electronobserver/smartnixie/README.md

<div align="center">

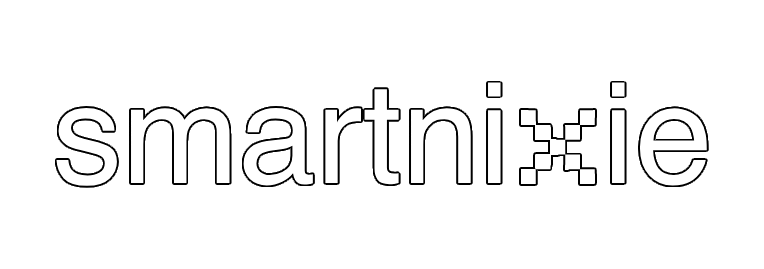
[picture p1: img/smartnixie.png]
Smart Nixie Smartnixie: An ESP32 powered smart home nixie clock


<span>━━━━━━ ⬢ ━━━━━━</span>

An ESP32-powered smart home Nixie Clock with customizable RGB backlighting, Wi-Fi connectivity, and a companion control app.

[About](#about) | [Guide](/) | [Credits](/)

---
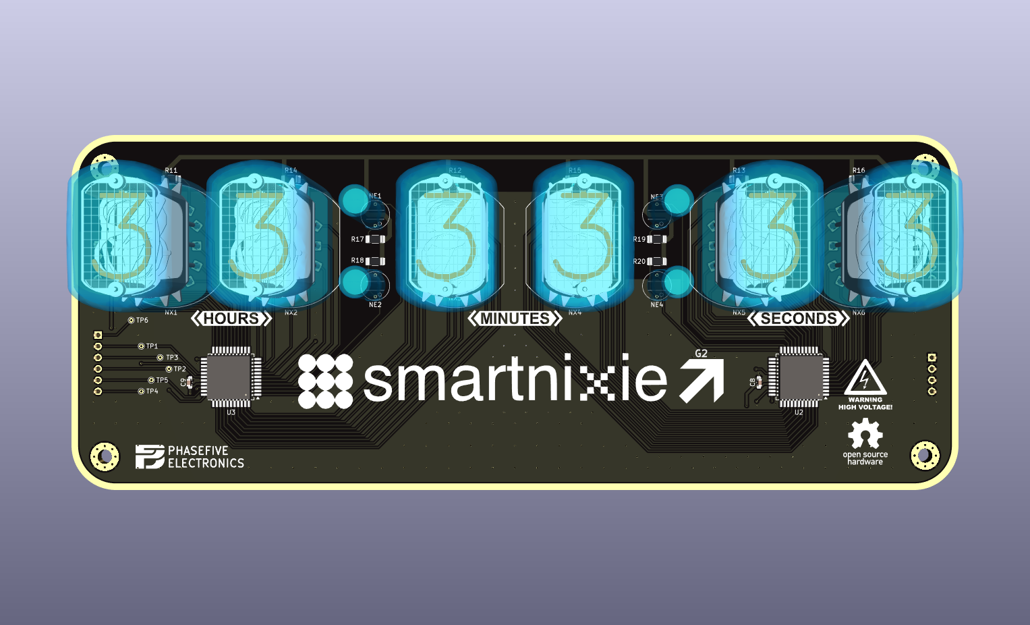
[picture p2: img/clock_face.png]
Front Clock Face PCB

(Display Board PCB)

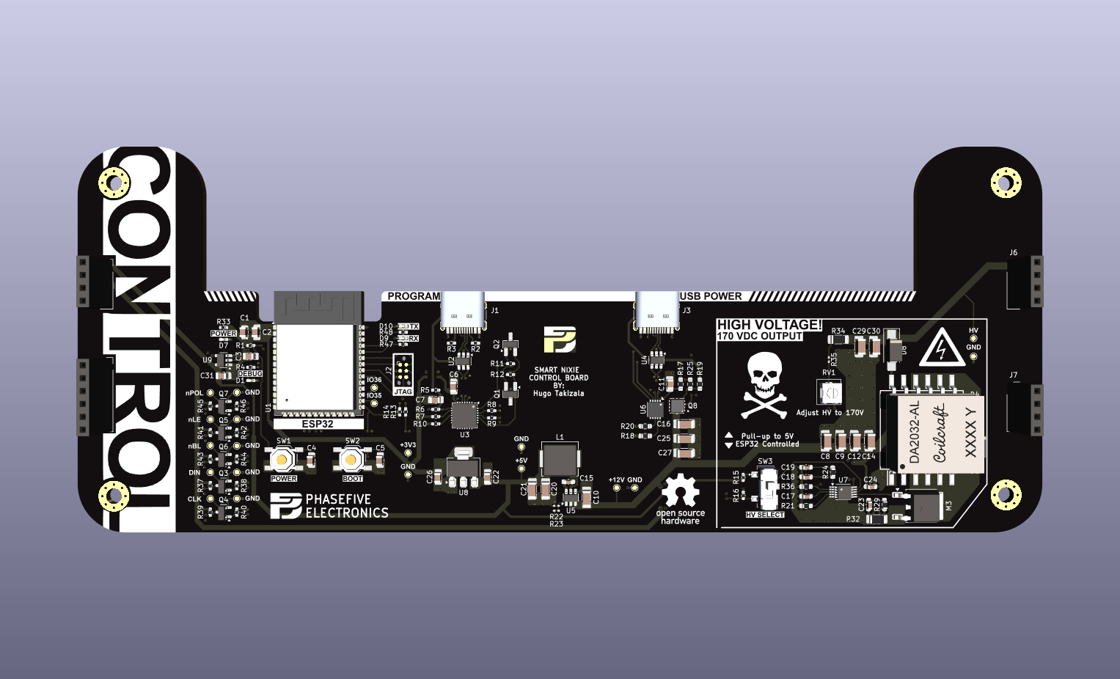
[picture p3: img/control_board.png]
Front Control Board PCB

(Control Board PCB)
</div>

# About

> [!WARNING]
> This project is currently a work in progress and as of now, no hardware has been tested. Take everything on this repository with a grain of salt. You can read up on this project's development process [here](https://electron.observer/posts/smartnixie).
>
# Credits
- **Symbols and Footprints:** [Nixies US](https://github.com/judge2005/Eagle-and-KiCAD-Nixie-Libs)
- **HV Power Supply:** [Tony Pottier (tonyp7)](https://github.com/tonyp7/170v-nixie-power-supply)
