electronobserver/smartnixie/hardware/img/clock_face_3D.png

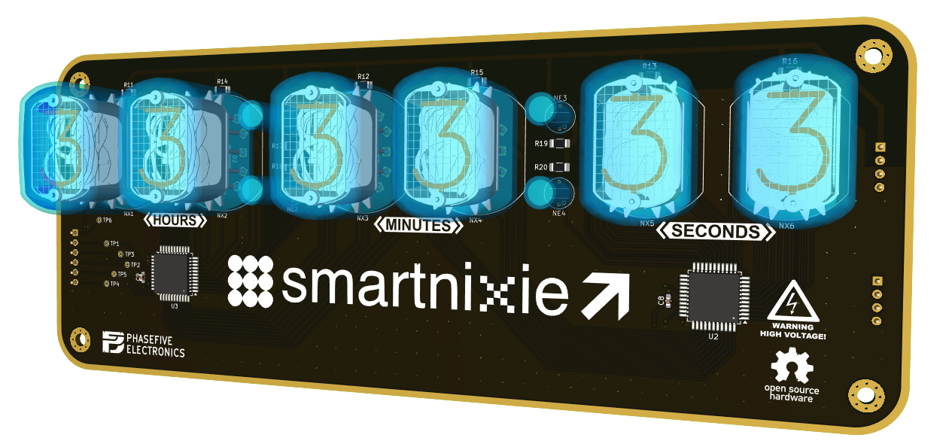
hardware/img/clock_face_3D.png
