electronobserver/smartnixie/hardware/img/control_board_3D_back.png

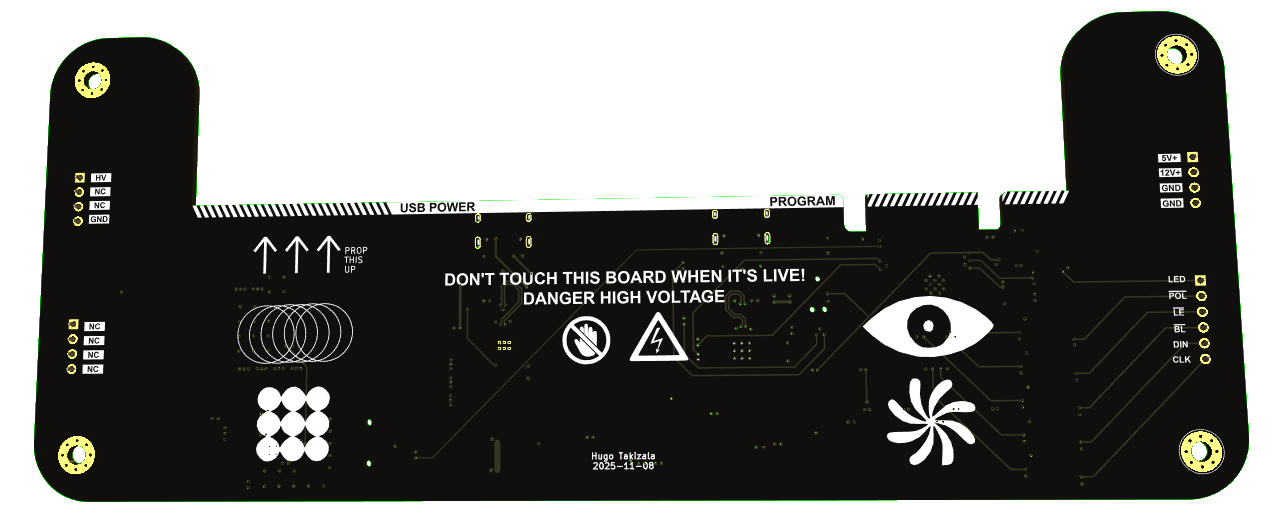
hardware/img/control_board_3D_back.png
