electronobserver/smartnixie/hardware/img/control_board_3D_front.png

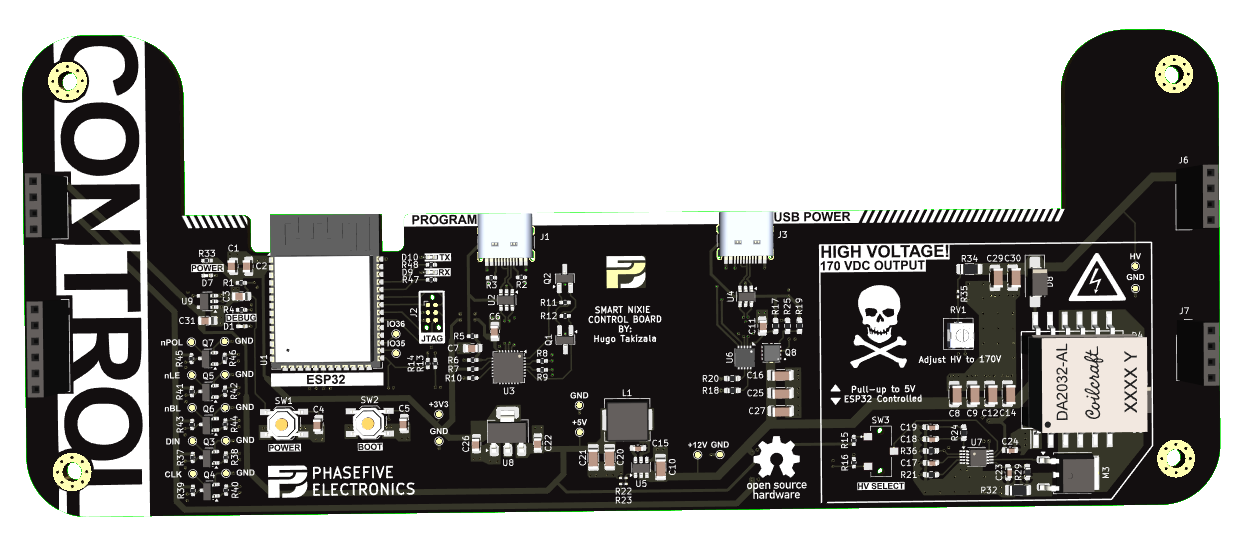
hardware/img/control_board_3D_front.png
