electronobserver/smartnixie/hardware/img/USB-C.jpeg

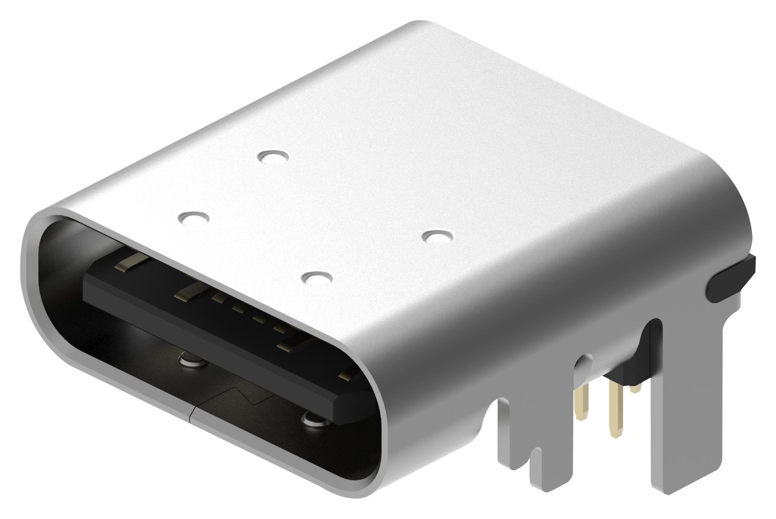
hardware/img/USB-C.jpeg
