electronobserver/smartnixie/hardware/models/3314J-1-100E.STEP

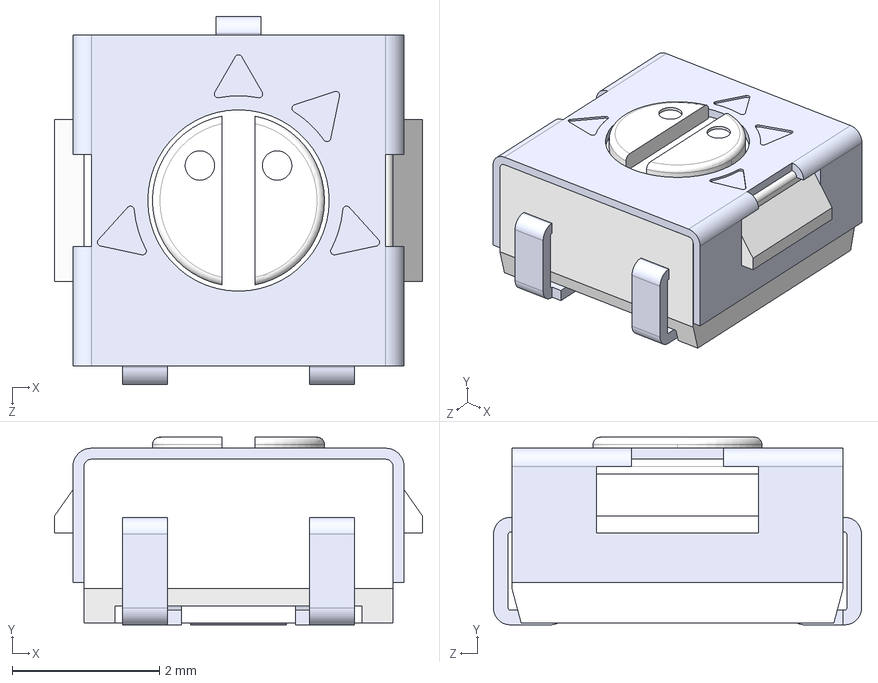
[picture p8: CAD file, 2025-09-29]
hardware/models/3314J-1-100E.STEP
5.00 x 2.55 x 5.00 mm
