electronobserver/smartnixie/hardware/models/CL-SB-12B-01T.step

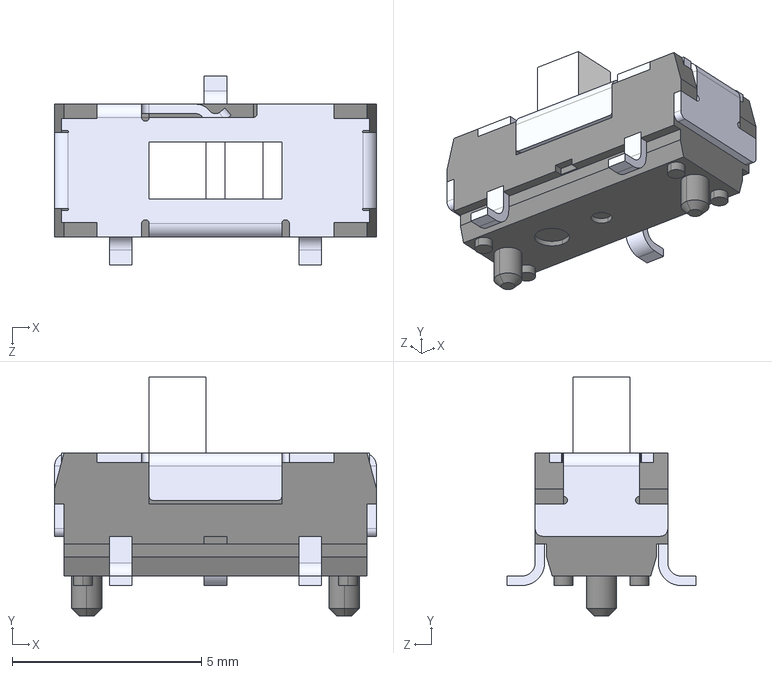
[picture p9: CAD file, 2025-09-29]
hardware/models/CL-SB-12B-01T.step
8.50 x 6.30 x 5.00 mm
