electronobserver/smartnixie/hardware/models/WS2812B.step

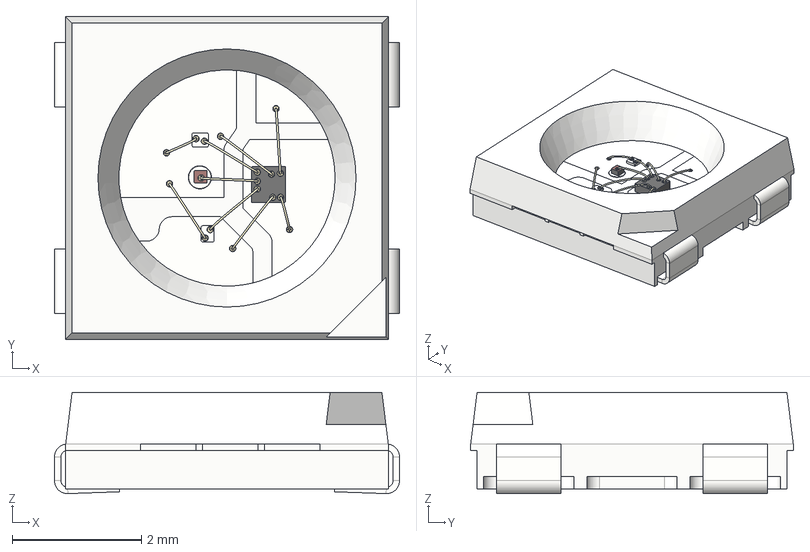
[picture p10: CAD file, 2025-09-29]
hardware/models/WS2812B.step
5.35 x 5.00 x 1.57 mm
