electronobserver/smartnixie/hardware/models/IN-12A.STEP

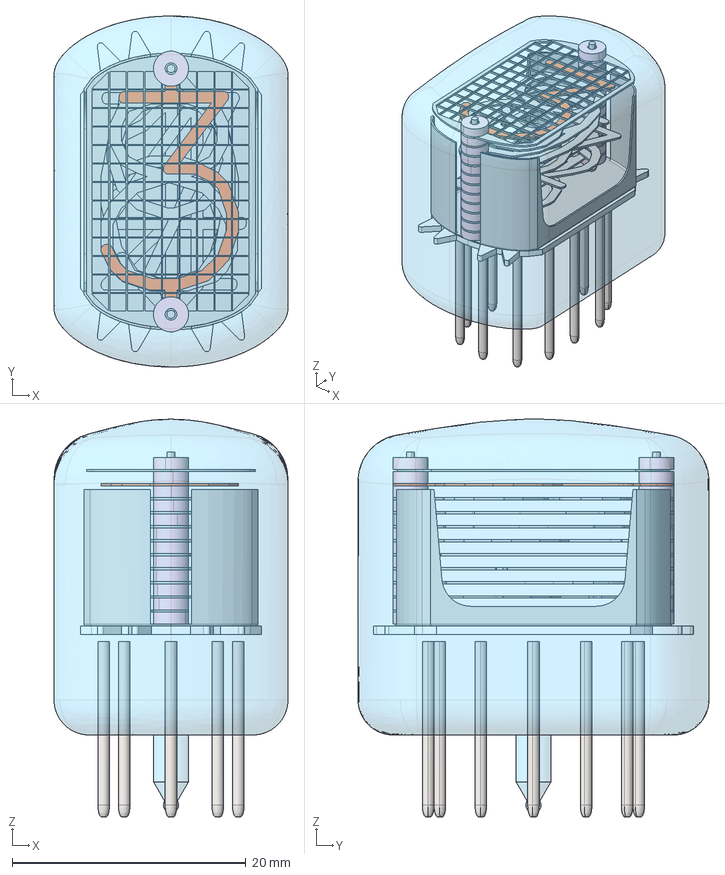
[picture p11: CAD file, 2025-09-29]
hardware/models/IN-12A.STEP
20.0 x 30.0 x 34.0 mm
IN-12 nixie tube glass body
IN-12 nixie tube pin x 12
IN-12 nixie tube anode grid
IN-12 nixie tube 0 digit
IN-12 nixie tube 1 digit
IN-12 nixie tube 2 digit
IN-12 nixie tube 3 digit
IN-12 nixie tube 4 digit
IN-12 nixie tube 5 digit
IN-12 nixie tube 6 digit
IN-12 nixie tube 7 digit
IN-12 nixie tube 8 digit
IN-12 nixie tube 9 digit
IN-12 nixie tube spacer x 24
IN-12 nixie tube rod x 2
IN-12 nixie tube back plate 1
IN-12 nixie tube back plate 2
