electronobserver/smartnixie/hardware/models/USB Type C Port (SMD Type).STEP

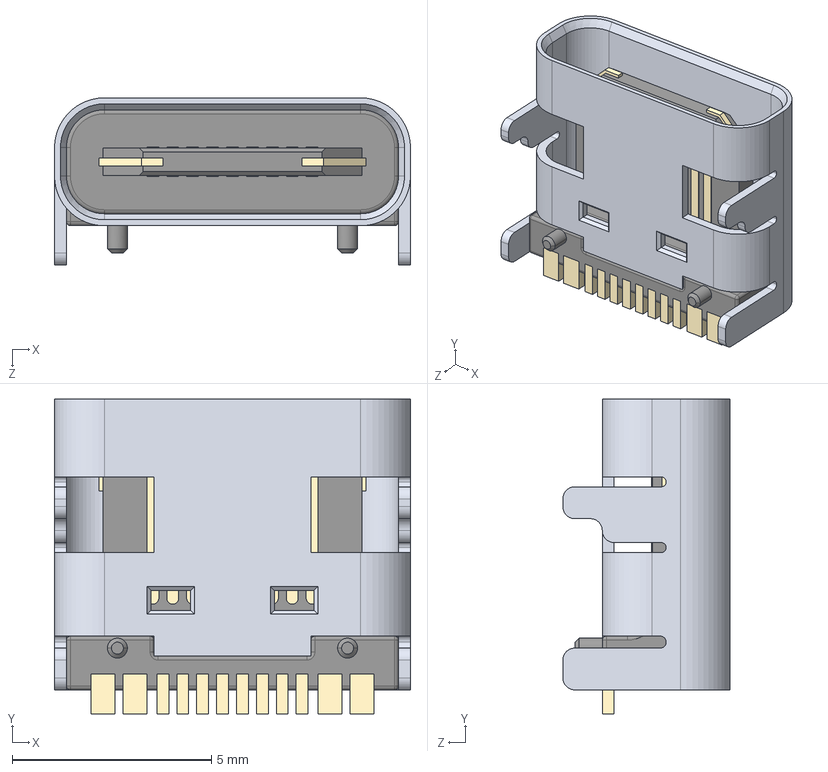
[picture p12: CAD file, 2025-09-29]
hardware/models/USB Type C Port (SMD Type).STEP
8.94 x 7.90 x 4.20 mm
