electronobserver/smartnixie/hardware/models/AONR21307.step

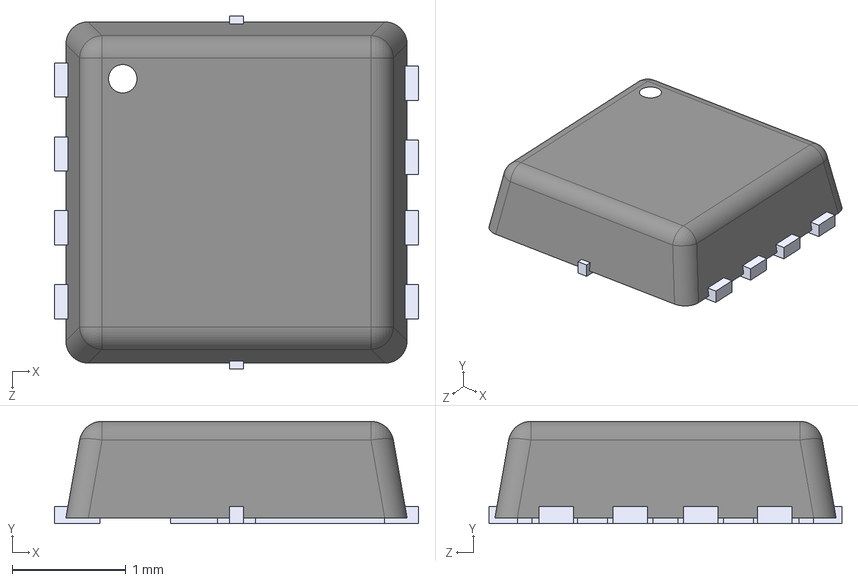
[picture p13: CAD file, 2025-09-29]
hardware/models/AONR21307.step
3.20 x 0.9 x 3.10 mm
