electronobserver/smartnixie/hardware/models/Coilcraft-DA2032-AL.STEP

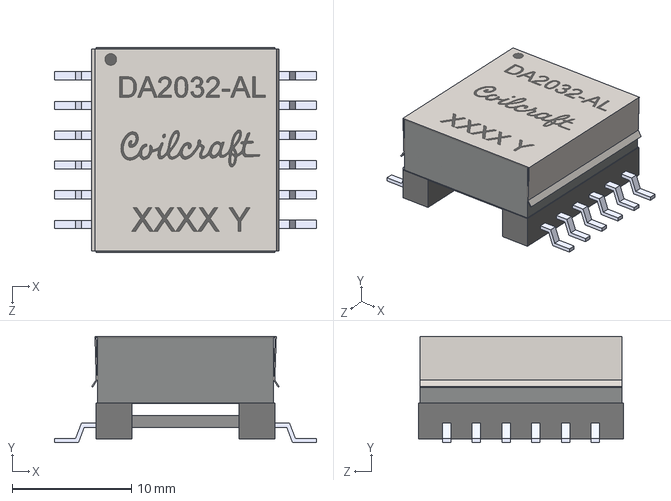
[picture p14: CAD file, 2025-09-29]
hardware/models/Coilcraft-DA2032-AL.STEP
22.0 x 8.94 x 17.2 mm
