electronobserver/smartnixie/hardware/models/INS1.STEP

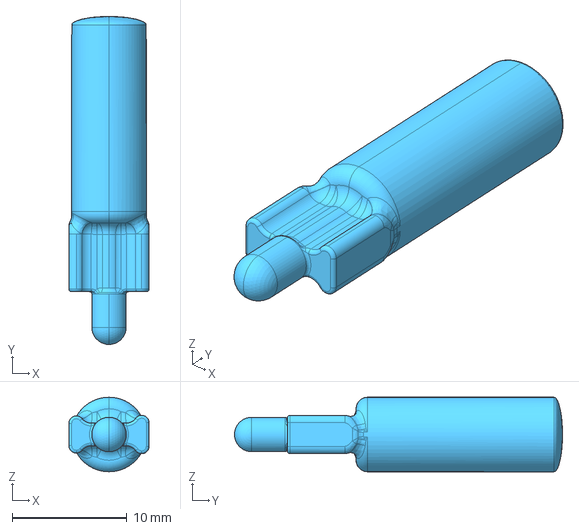
[picture p15: CAD file, 2025-09-29]
hardware/models/INS1.STEP
7.00 x 28.6 x 6.50 mm
