electronobserver/smartnixie/hardware/models/User Library-My-DFN-10-3x3-0_5.STEP

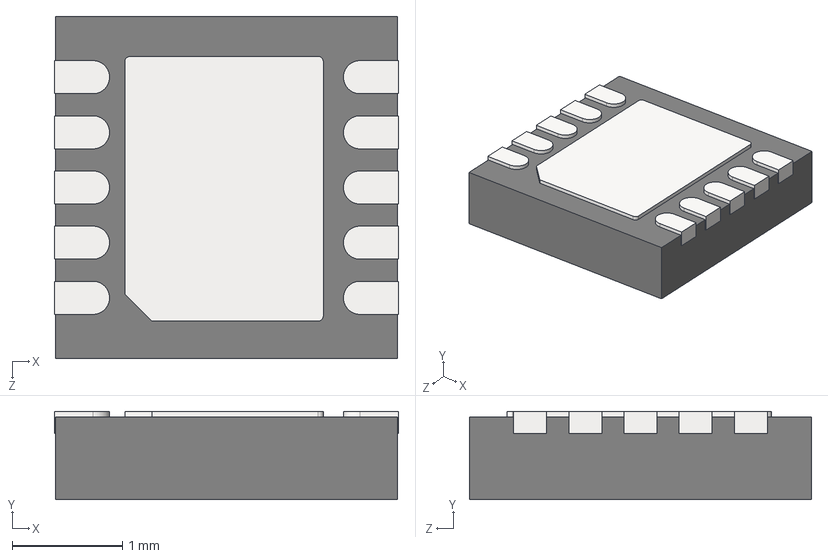
[picture p16: CAD file, 2025-09-29]
hardware/models/User Library-My-DFN-10-3x3-0_5.STEP
3.12 x 0.8 x 3.10 mm
TP
