electronobserver/smartnixie/hardware/models/TPS61088RHLR.step

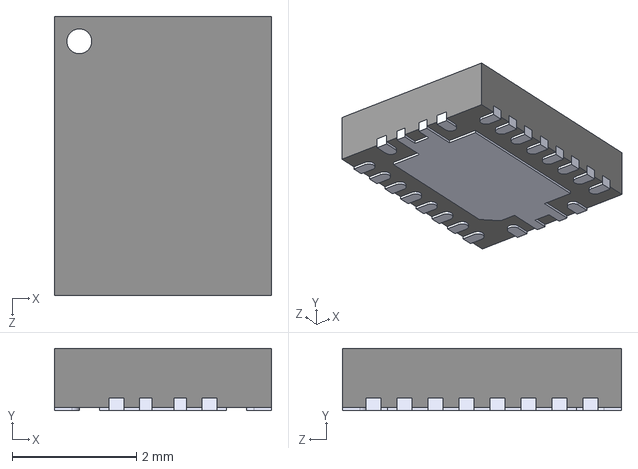
[picture p17: CAD file, 2025-09-29]
hardware/models/TPS61088RHLR.step
3.50 x 1.00 x 4.50 mm
