electronobserver/smartnixie/hardware/clock_face/clock_face.kicad_pcb

## KiCad design hardware/clock_face/clock_face.kicad_pcb (2025-11-08)

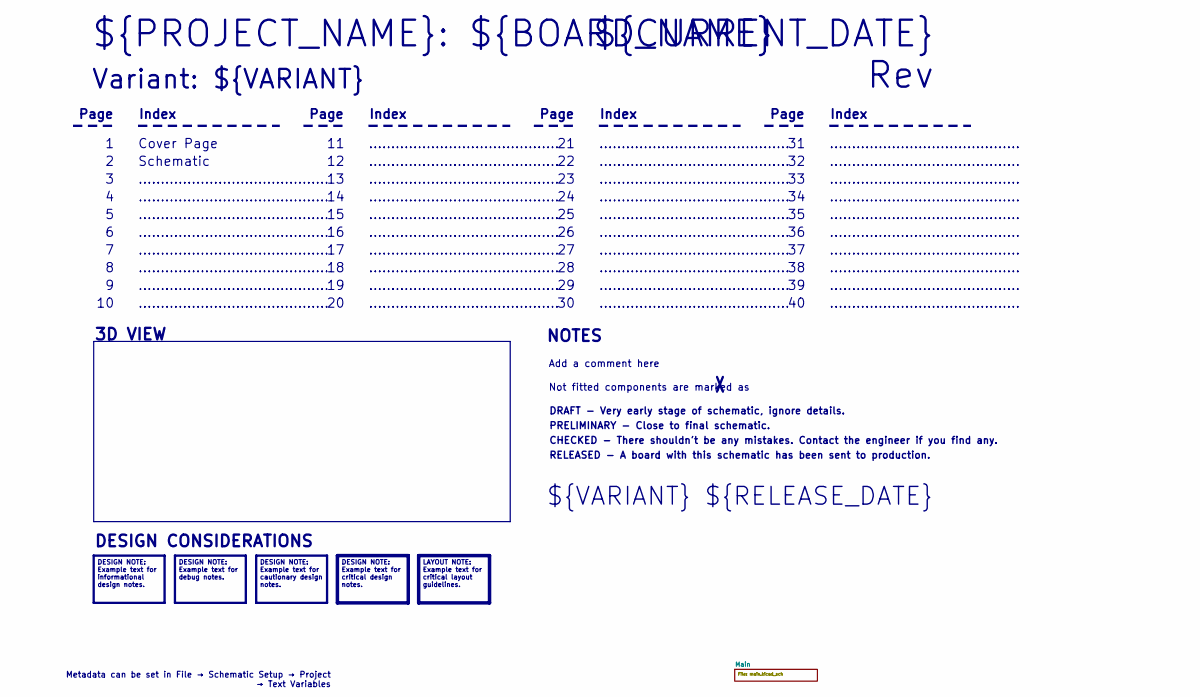
[picture p18: schematic clock_face.kicad_sch]

Notes on the sheet:
Metadata can be set in File → Schematic Setup → Project → Text Variables
DESIGN NOTE: Example text for informational design notes.
LAYOUT NOTE: Example text for critical layout guidelines.
DESIGN NOTE: Example text for cautionary design notes.
DESIGN NOTE: Example text for debug notes.
DESIGN NOTE: Example text for critical design notes.
...........................................
RELEASED - A board with this schematic has been sent to production.
Page
3D VIEW
Not fitted components are marked as
Index
PRELIMINARY - Close to final schematic.
${VARIANT} ${RELEASE_DATE}
${CURRENT_DATE}
Variant: ${VARIANT}
Rev ${REVISION}
${PROJECT_NAME}: ${BOARD_NAME}
DRAFT - Very early stage of schematic, ignore details.
Schematic
Add a comment here
Cover Page
NOTES
CHECKED - There shouldn't be any mistakes. Contact the engineer if you find any.
DESIGN CONSIDERATIONS

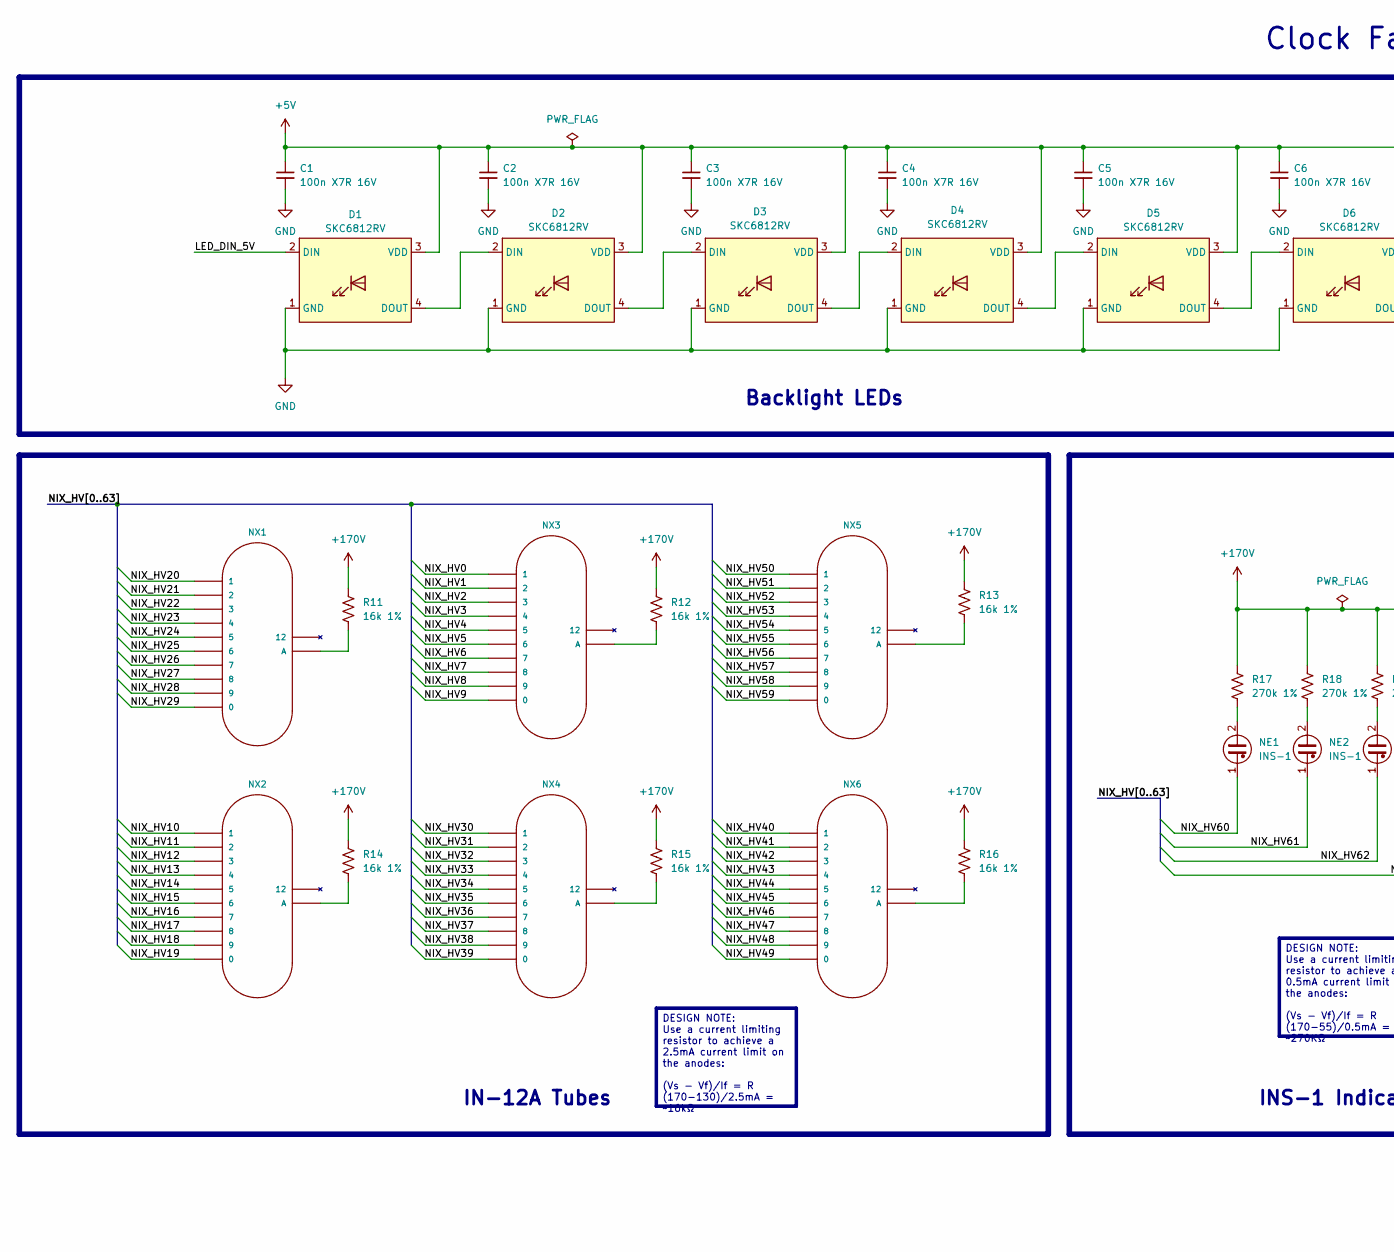
[picture p19: schematic main.kicad_sch, part in row 1, column 1]

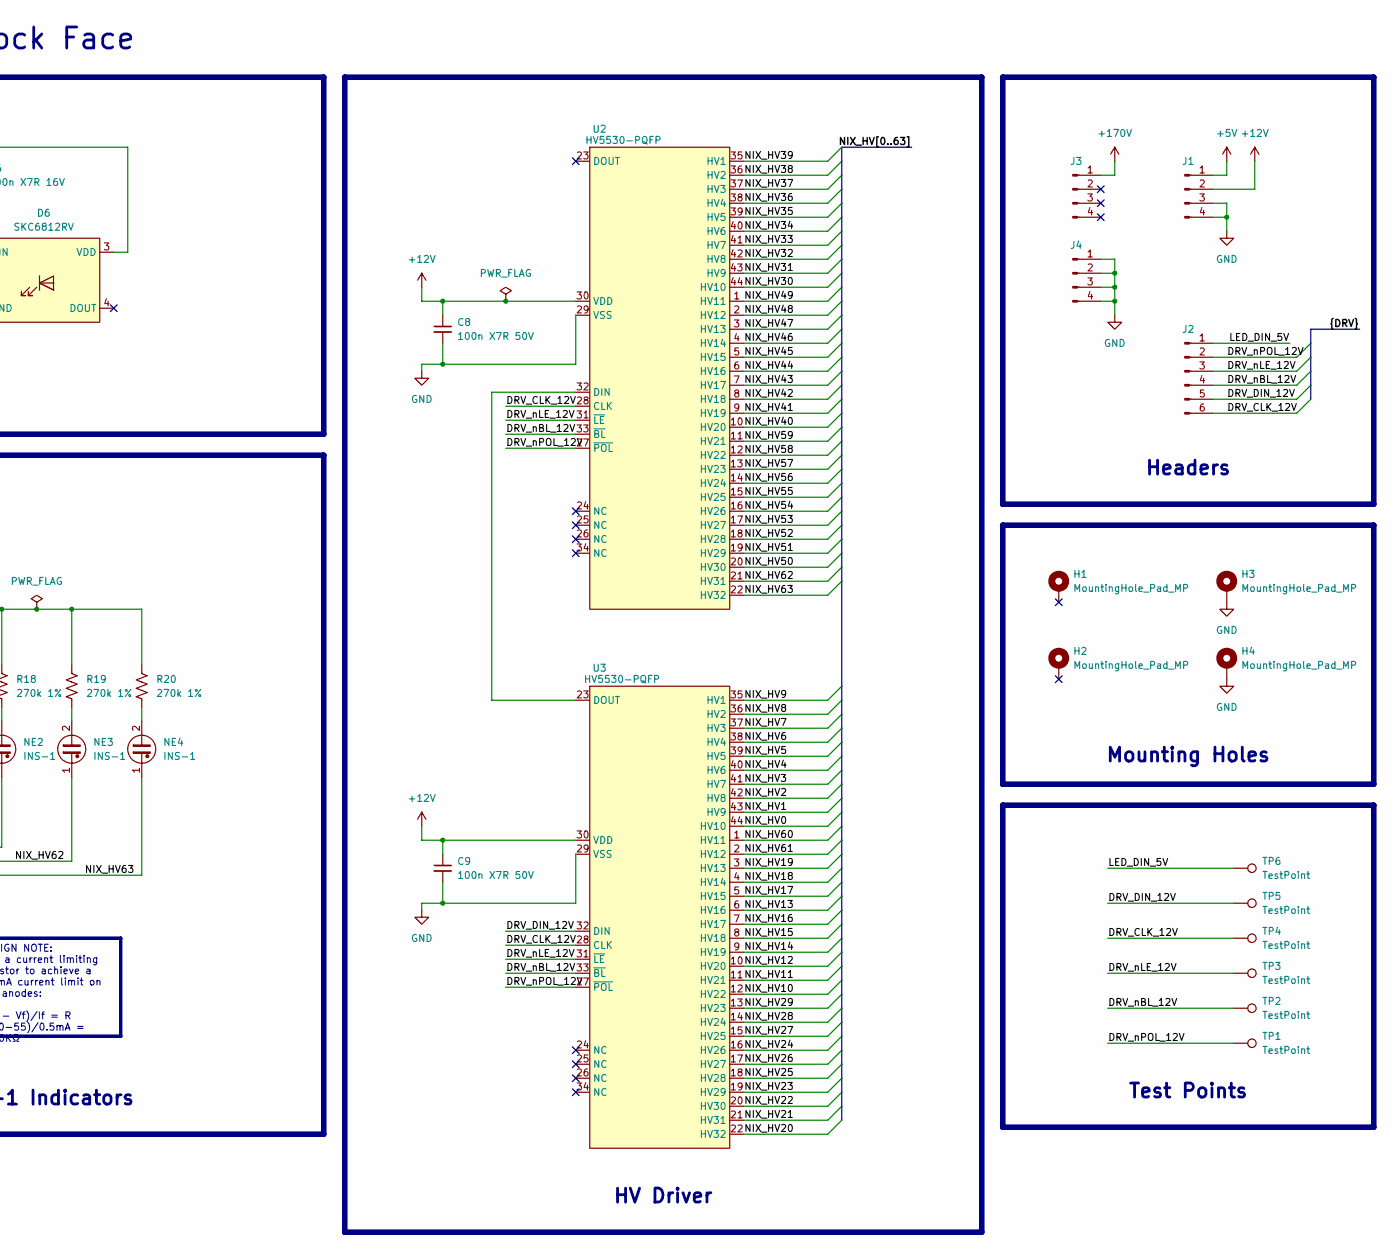
[picture p20: schematic main.kicad_sch, part in row 1, column 2]

Parts:
C1, C2, C3, C4, C5, C6: 100n X7R 16V; C_0805_2012Metric_Pad1.18x1.45mm_HandSolder; Part No. CC0805KRX7R7BB104
C8, C9: 100n X7R 50V; C_0603_1608Metric_Pad1.08x0.95mm_HandSolder; Part No. CC0603KRX7R9BB104
D1, D2, D3, D4, D5, D6: SKC6812RV
H1, H2, H3, H4: MountingHole_Pad_MP; MountingHole_3.2mm_M3_Pad_Via
J1, J3, J4: Conn_01x04_Pin; PinHeader_1x04_P2.54mm_Vertical
J2: Conn_01x06_Pin; PinHeader_1x06_P2.54mm_Vertical
NE1, NE2, NE3, NE4: INS-1; INS_1
NX1, NX2, NX3, NX4, NX5, NX6: IN-12A; IN_12A
R11, R12, R13, R14, R15, R16: 16k 1%; R_1206_3216Metric_Pad1.30x1.75mm_HandSolder; Part No. RC1206FR-0716KL
R17, R18, R19, R20: 270k 1%; R_1206_3216Metric_Pad1.30x1.75mm_HandSolder; Part No. RC1206FR-07270KL
TP1, TP2, TP3, TP4, TP5, TP6: TestPoint; TestPoint_THTPad_D1.0mm_Drill0.5mm
U2, U3: HV5530-PQFP; PQFP-44_10x10mm_P0.8mm

Connections:
+5V: C1.1, C2.1, C3.1, C4.1, C5.1, C6.1, D1.3 (VDD), D2.3 (VDD), D3.3 (VDD), D4.3 (VDD), D5.3 (VDD), D6.3 (VDD), J1.1
+12V: C8.1, C9.1, J1.2, U2.30 (VDD), U3.30 (VDD)
+170V: J3.1, R11.1, R12.1, R13.1, R14.1, R15.1, R16.1, R17.1, R18.1, R19.1, R20.1
/Main/DRV_CLK_12V: J2.6, TP4.1, U2.28 (CLK), U3.28 (CLK)
/Main/DRV_DIN_12V: J2.5, TP5.1, U3.32 (DIN)
/Main/DRV_nBL_12V: J2.4, TP2.1, U2.33 (~BL), U3.33 (~BL)
/Main/DRV_nLE_12V: J2.3, TP3.1, U2.31 (~LE), U3.31 (~LE)
/Main/DRV_nPOL_12V: J2.2, TP1.1, U2.27 (~POL), U3.27 (~POL)
/Main/LED_DIN_5V: D1.2 (DIN), J2.1, TP6.1
/Main/NIX_HV0: NX3.11 (1), U3.44 (HV10)
/Main/NIX_HV1: NX3.10 (2), U3.43 (HV9)
/Main/NIX_HV2: NX3.9 (3), U3.42 (HV8)
/Main/NIX_HV3: NX3.8 (4), U3.41 (HV7)
/Main/NIX_HV4: NX3.7 (5), U3.40 (HV6)
/Main/NIX_HV5: NX3.6, U3.39 (HV5)
/Main/NIX_HV6: NX3.5 (7), U3.38 (HV4)
/Main/NIX_HV7: NX3.4 (8), U3.37 (HV3)
/Main/NIX_HV8: NX3.3 (9), U3.36 (HV2)
/Main/NIX_HV9: NX3.2 (0), U3.35 (HV1)
/Main/NIX_HV10: NX2.11 (1), U3.12 (HV22)
/Main/NIX_HV11: NX2.10 (2), U3.11 (HV21)
/Main/NIX_HV12: NX2.9 (3), U3.10 (HV20)
/Main/NIX_HV13: NX2.8 (4), U3.6 (HV16)
/Main/NIX_HV14: NX2.7 (5), U3.9 (HV19)
/Main/NIX_HV15: NX2.6, U3.8 (HV18)
/Main/NIX_HV16: NX2.5 (7), U3.7 (HV17)
/Main/NIX_HV17: NX2.4 (8), U3.5 (HV15)
/Main/NIX_HV18: NX2.3 (9), U3.4 (HV14)
/Main/NIX_HV19: NX2.2 (0), U3.3 (HV13)
/Main/NIX_HV20: NX1.11 (1), U3.22 (HV32)
/Main/NIX_HV21: NX1.10 (2), U3.21 (HV31)
/Main/NIX_HV22: NX1.9 (3), U3.20 (HV30)
/Main/NIX_HV23: NX1.8 (4), U3.19 (HV29)
/Main/NIX_HV24: NX1.7 (5), U3.16 (HV26)
/Main/NIX_HV25: NX1.6, U3.18 (HV28)
/Main/NIX_HV26: NX1.5 (7), U3.17 (HV27)
/Main/NIX_HV27: NX1.4 (8), U3.15 (HV25)
/Main/NIX_HV28: NX1.3 (9), U3.14 (HV24)
/Main/NIX_HV29: NX1.2 (0), U3.13 (HV23)
/Main/NIX_HV30: NX4.11 (1), U2.44 (HV10)
/Main/NIX_HV31: NX4.10 (2), U2.43 (HV9)
/Main/NIX_HV32: NX4.9 (3), U2.42 (HV8)
/Main/NIX_HV33: NX4.8 (4), U2.41 (HV7)
/Main/NIX_HV34: NX4.7 (5), U2.40 (HV6)
/Main/NIX_HV35: NX4.6, U2.39 (HV5)
/Main/NIX_HV36: NX4.5 (7), U2.38 (HV4)
/Main/NIX_HV37: NX4.4 (8), U2.37 (HV3)
/Main/NIX_HV38: NX4.3 (9), U2.36 (HV2)
/Main/NIX_HV39: NX4.2 (0), U2.35 (HV1)
/Main/NIX_HV40: NX6.11 (1), U2.10 (HV20)
/Main/NIX_HV41: NX6.10 (2), U2.9 (HV19)
/Main/NIX_HV42: NX6.9 (3), U2.8 (HV18)
/Main/NIX_HV43: NX6.8 (4), U2.7 (HV17)
/Main/NIX_HV44: NX6.7 (5), U2.6 (HV16)
/Main/NIX_HV45: NX6.6, U2.5 (HV15)
/Main/NIX_HV46: NX6.5 (7), U2.4 (HV14)
/Main/NIX_HV47: NX6.4 (8), U2.3 (HV13)
/Main/NIX_HV48: NX6.3 (9), U2.2 (HV12)
/Main/NIX_HV49: NX6.2 (0), U2.1 (HV11)
/Main/NIX_HV50: NX5.11 (1), U2.20 (HV30)
/Main/NIX_HV51: NX5.10 (2), U2.19 (HV29)
/Main/NIX_HV52: NX5.9 (3), U2.18 (HV28)
/Main/NIX_HV53: NX5.8 (4), U2.17 (HV27)
/Main/NIX_HV54: NX5.7 (5), U2.16 (HV26)
/Main/NIX_HV55: NX5.6, U2.15 (HV25)
/Main/NIX_HV56: NX5.5 (7), U2.14 (HV24)
/Main/NIX_HV57: NX5.4 (8), U2.13 (HV23)
/Main/NIX_HV58: NX5.3 (9), U2.12 (HV22)
/Main/NIX_HV59: NX5.2 (0), U2.11 (HV21)
/Main/NIX_HV60: NE1.1, U3.1 (HV11)
/Main/NIX_HV61: NE2.1, U3.2 (HV12)
/Main/NIX_HV62: NE3.1, U2.21 (HV31)
/Main/NIX_HV63: NE4.1, U2.22 (HV32)
GND: C1.2, C2.2, C3.2, C4.2, C5.2, C6.2, C8.2, C9.2, D1.1 (GND), D2.1 (GND), D3.1 (GND), D4.1 (GND), D5.1 (GND), D6.1 (GND), H3.1 (MP), H4.1 (MP), J1.3, J1.4, J4.1, J4.2, J4.3, J4.4, U2.29 (VSS), U3.29 (VSS)
unnamed: D1.4 (DOUT), D2.2 (DIN)
unnamed: D2.4 (DOUT), D3.2 (DIN)
unnamed: D3.4 (DOUT), D4.2 (DIN)
unnamed: D4.4 (DOUT), D5.2 (DIN)
unnamed: D5.4 (DOUT), D6.2 (DIN)
unnamed: NE1.2, R17.2
unnamed: NE2.2, R18.2
unnamed: NE3.2, R19.2
unnamed: NE4.2, R20.2
unnamed: NX1.1 (A), R11.2
unnamed: NX2.1 (A), R14.2
unnamed: NX3.1 (A), R12.2
unnamed: NX4.1 (A), R15.2
unnamed: NX5.1 (A), R13.2
unnamed: NX6.1 (A), R16.2
unnamed: U2.32 (DIN), U3.23 (DOUT)

Notes on the sheet:
HV Driver
Headers
DESIGN NOTE: Use a current limiting resistor to achieve a 2.5mA current limit on the anodes: (Vs - Vf)/If = R (170-130)/2.5mA = ~16kΩ
Test Points
Mounting Holes
INS-1 Indicators
DESIGN NOTE: Use a current limiting resistor to achieve a 0.5mA current limit on the anodes: (Vs - Vf)/If = R (170-55)/0.5mA = ~270KΩ
Backlight LEDs
Clock Face
IN-12A Tubes

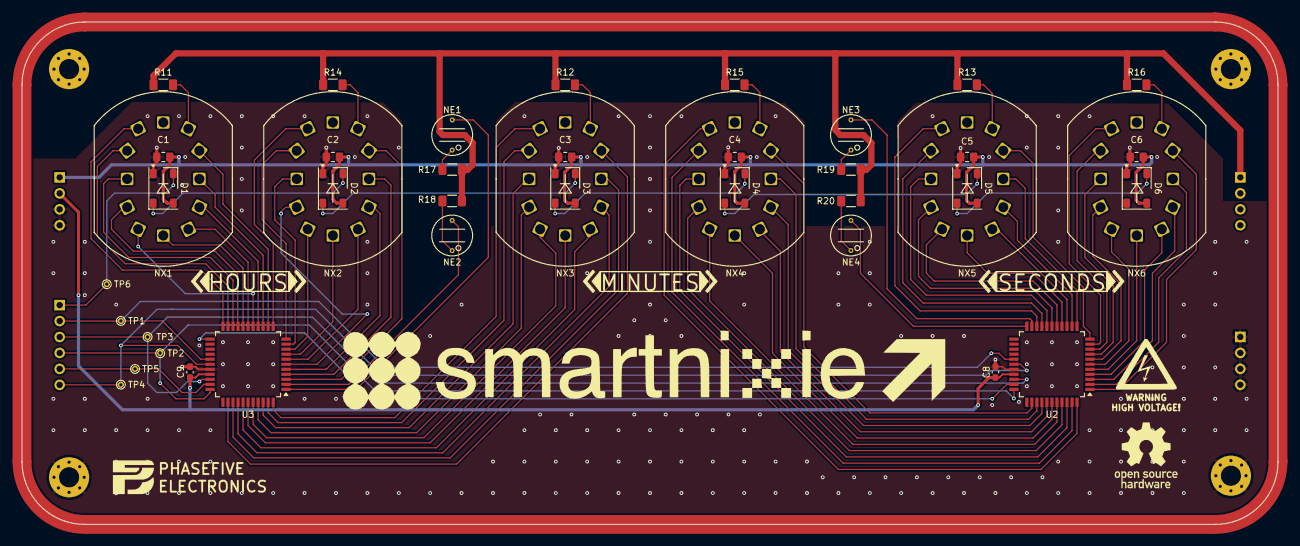
[picture p21: board clock_face.kicad_pcb from above]

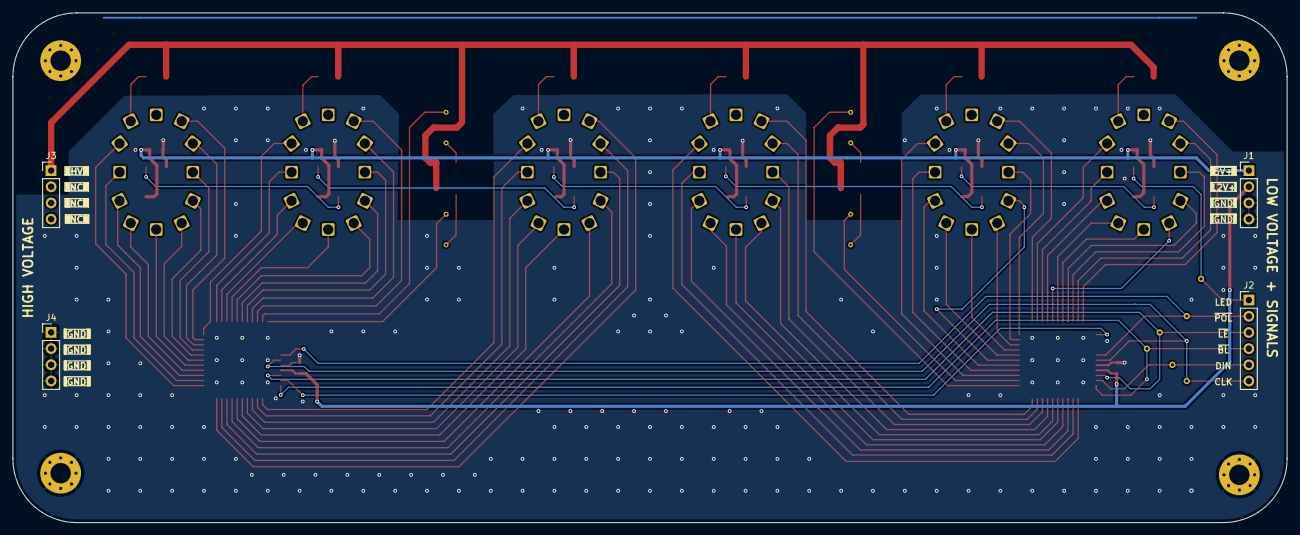
[picture p22: board clock_face.kicad_pcb from below]

Board: 2 copper layers, 200.0 x 80.0 mm, 56 parts (4 on the bottom side), 90 nets.

Other parts of the board:
G1: LOGO; SmartNixie
G2: LOGO; Arrow
G3: LOGO; OSHW
G5: LOGO; P5Logo
G5#2: LOGO; HV
G6: LOGO; AbstractDecal1
