electronobserver/smartnixie/hardware/control_board/control_board.kicad_pcb

## KiCad design hardware/control_board/control_board.kicad_pcb (2025-11-08)

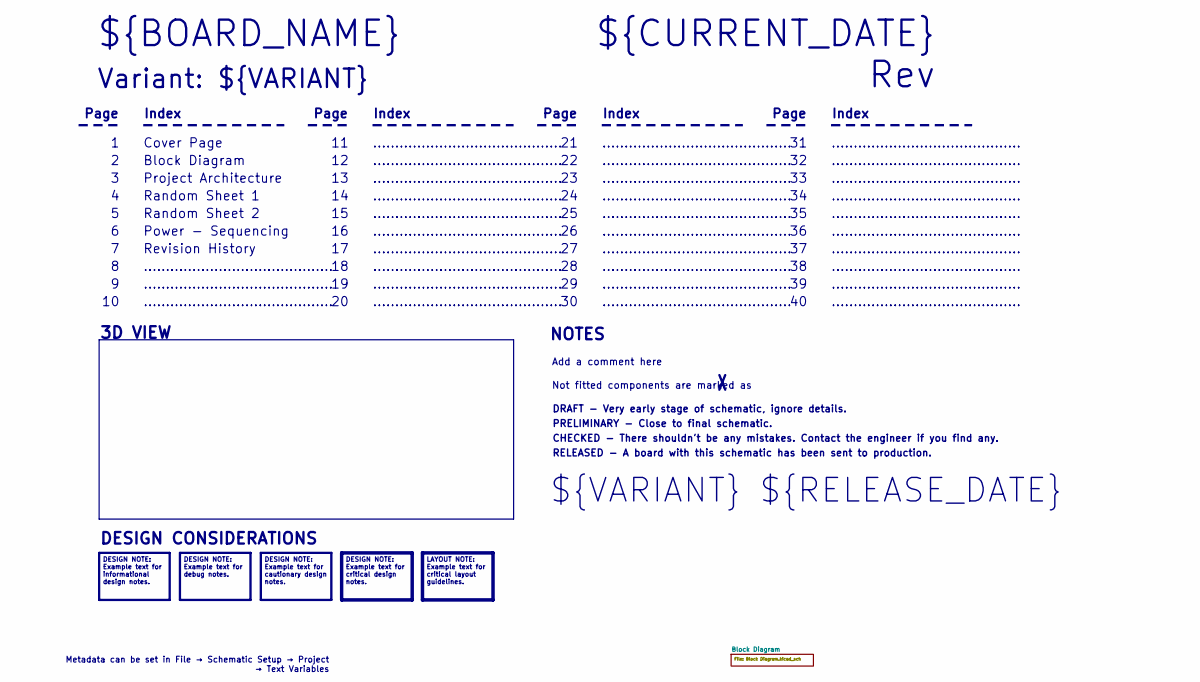
[picture p23: schematic control_board.kicad_sch]

Notes on the sheet:
Metadata can be set in File → Schematic Setup → Project → Text Variables
DESIGN NOTE: Example text for informational design notes.
LAYOUT NOTE: Example text for critical layout guidelines.
DESIGN NOTE: Example text for cautionary design notes.
DESIGN NOTE: Example text for debug notes.
DESIGN NOTE: Example text for critical design notes.
...........................................
RELEASED - A board with this schematic has been sent to production.
Page
3D VIEW
Not fitted components are marked as
Index
PRELIMINARY - Close to final schematic.
${VARIANT} ${RELEASE_DATE}
Random Sheet 1
${CURRENT_DATE}
Variant: ${VARIANT}
Rev ${REVISION}
Random Sheet 2
${BOARD_NAME}
DRAFT - Very early stage of schematic, ignore details.
Power - Sequencing
Block Diagram
Add a comment here
Cover Page
NOTES
Project Architecture
CHECKED - There shouldn't be any mistakes. Contact the engineer if you find any.
DESIGN CONSIDERATIONS
Revision History

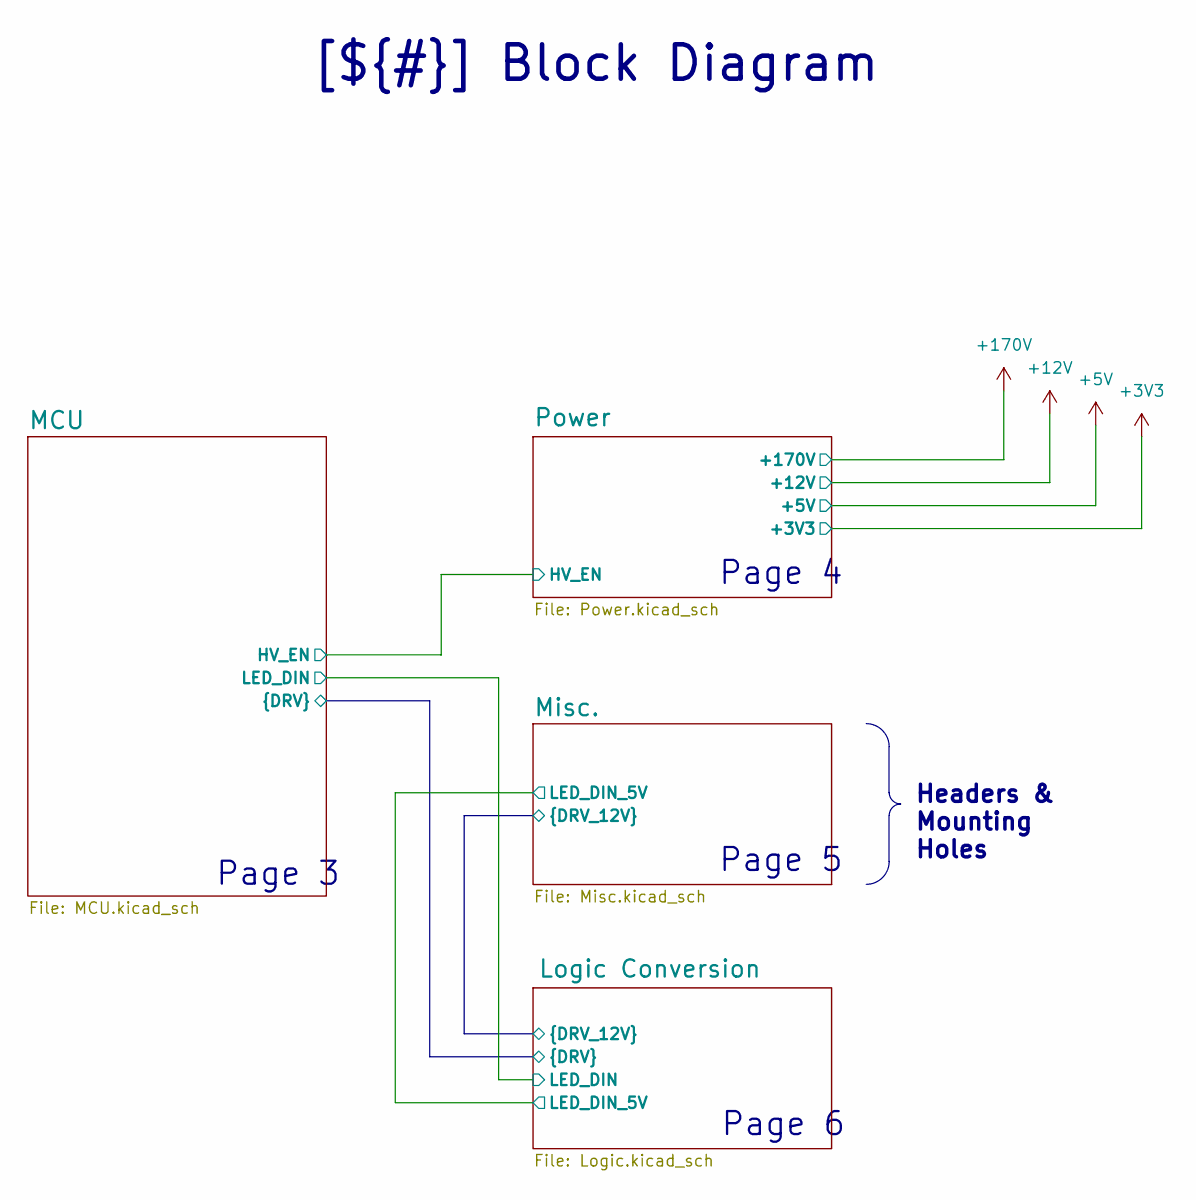
[picture p24: schematic Block Diagram.kicad_sch]

Notes on the sheet:
Headers & Mounting Holes
[${#}] Block Diagram
Page 6
Page 3
Page 5
Page 4

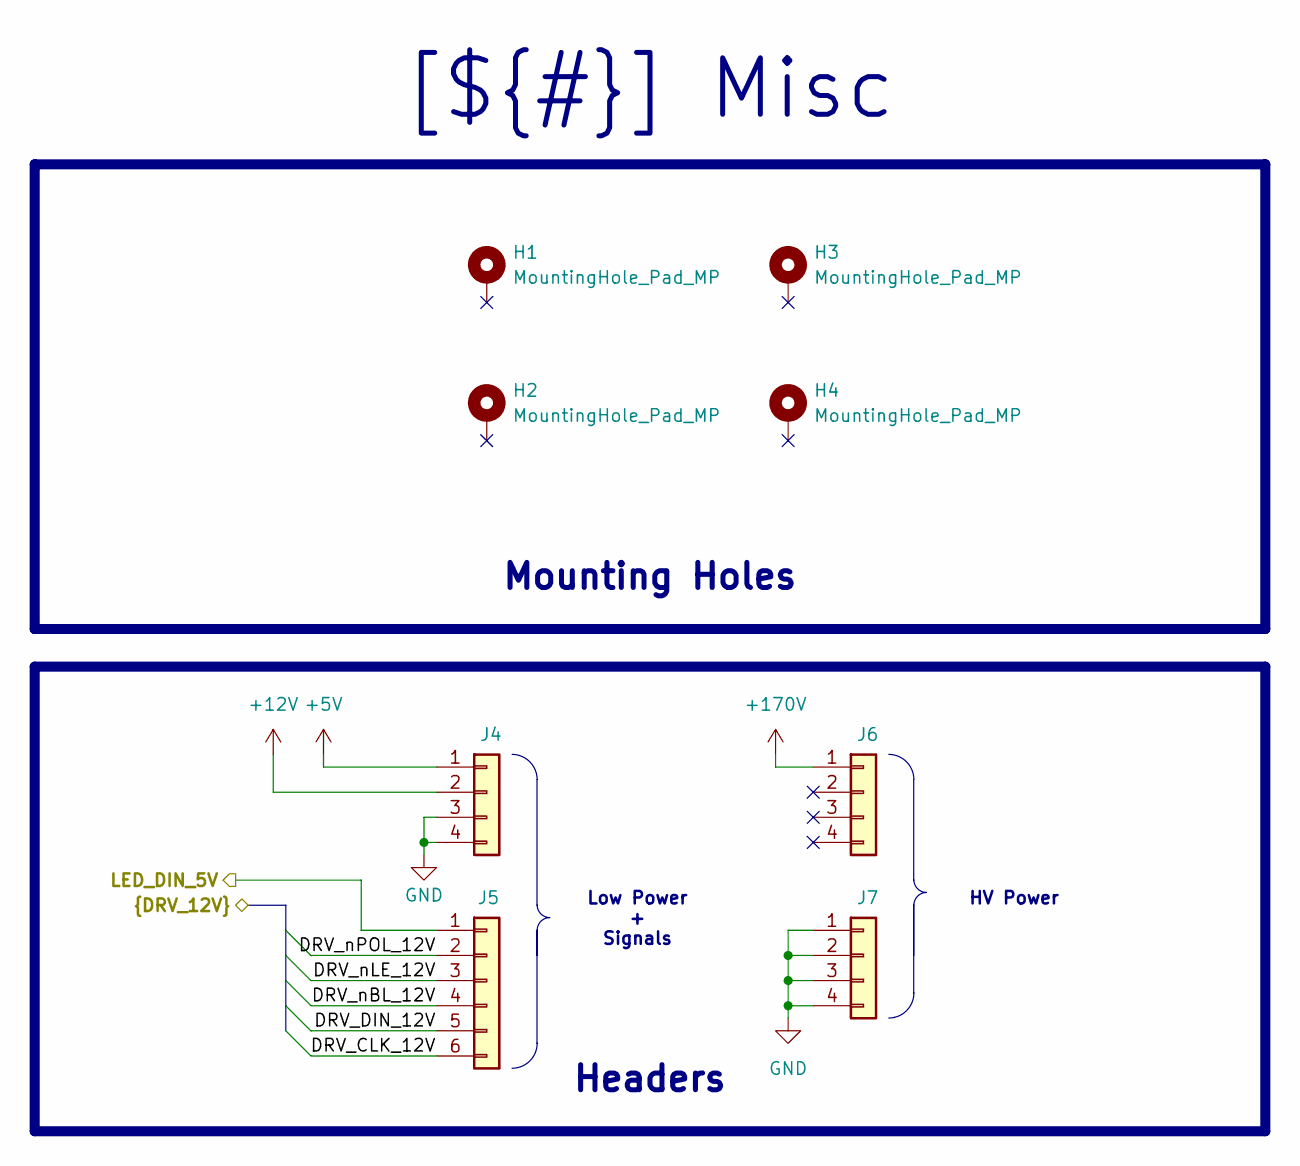
[picture p25: schematic Misc.kicad_sch]

Parts:
H1, H2, H3, H4: MountingHole_Pad_MP; MountingHole_3.2mm_M3_Pad_Via
J4, J6, J7: Conn_01x08; PinSocket_1x04_P2.54mm_Vertical
J5: Conn_01x08; PinSocket_1x06_P2.54mm_Vertical

Connections:
+5V: J4.1; also elsewhere on the board
+12V: J4.2; also elsewhere on the board
+170V: J6.1; also elsewhere on the board
/Block Diagram/Logic Conversion/DRV_CLK_12V: J5.6; also elsewhere on the board
/Block Diagram/Logic Conversion/DRV_DIN_12V: J5.5; also elsewhere on the board
/Block Diagram/Logic Conversion/DRV_nBL_12V: J5.4; also elsewhere on the board
/Block Diagram/Logic Conversion/DRV_nLE_12V: J5.3; also elsewhere on the board
/Block Diagram/Logic Conversion/DRV_nPOL_12V: J5.2; also elsewhere on the board
/Block Diagram/Logic Conversion/LED_DIN_5V: J5.1; also elsewhere on the board
GND: J4.3, J4.4, J7.1, J7.2, J7.3, J7.4; also elsewhere on the board

Notes on the sheet:
Low Power + Signals
Headers
Mounting Holes
HV Power
[${#}] ${TITLE}

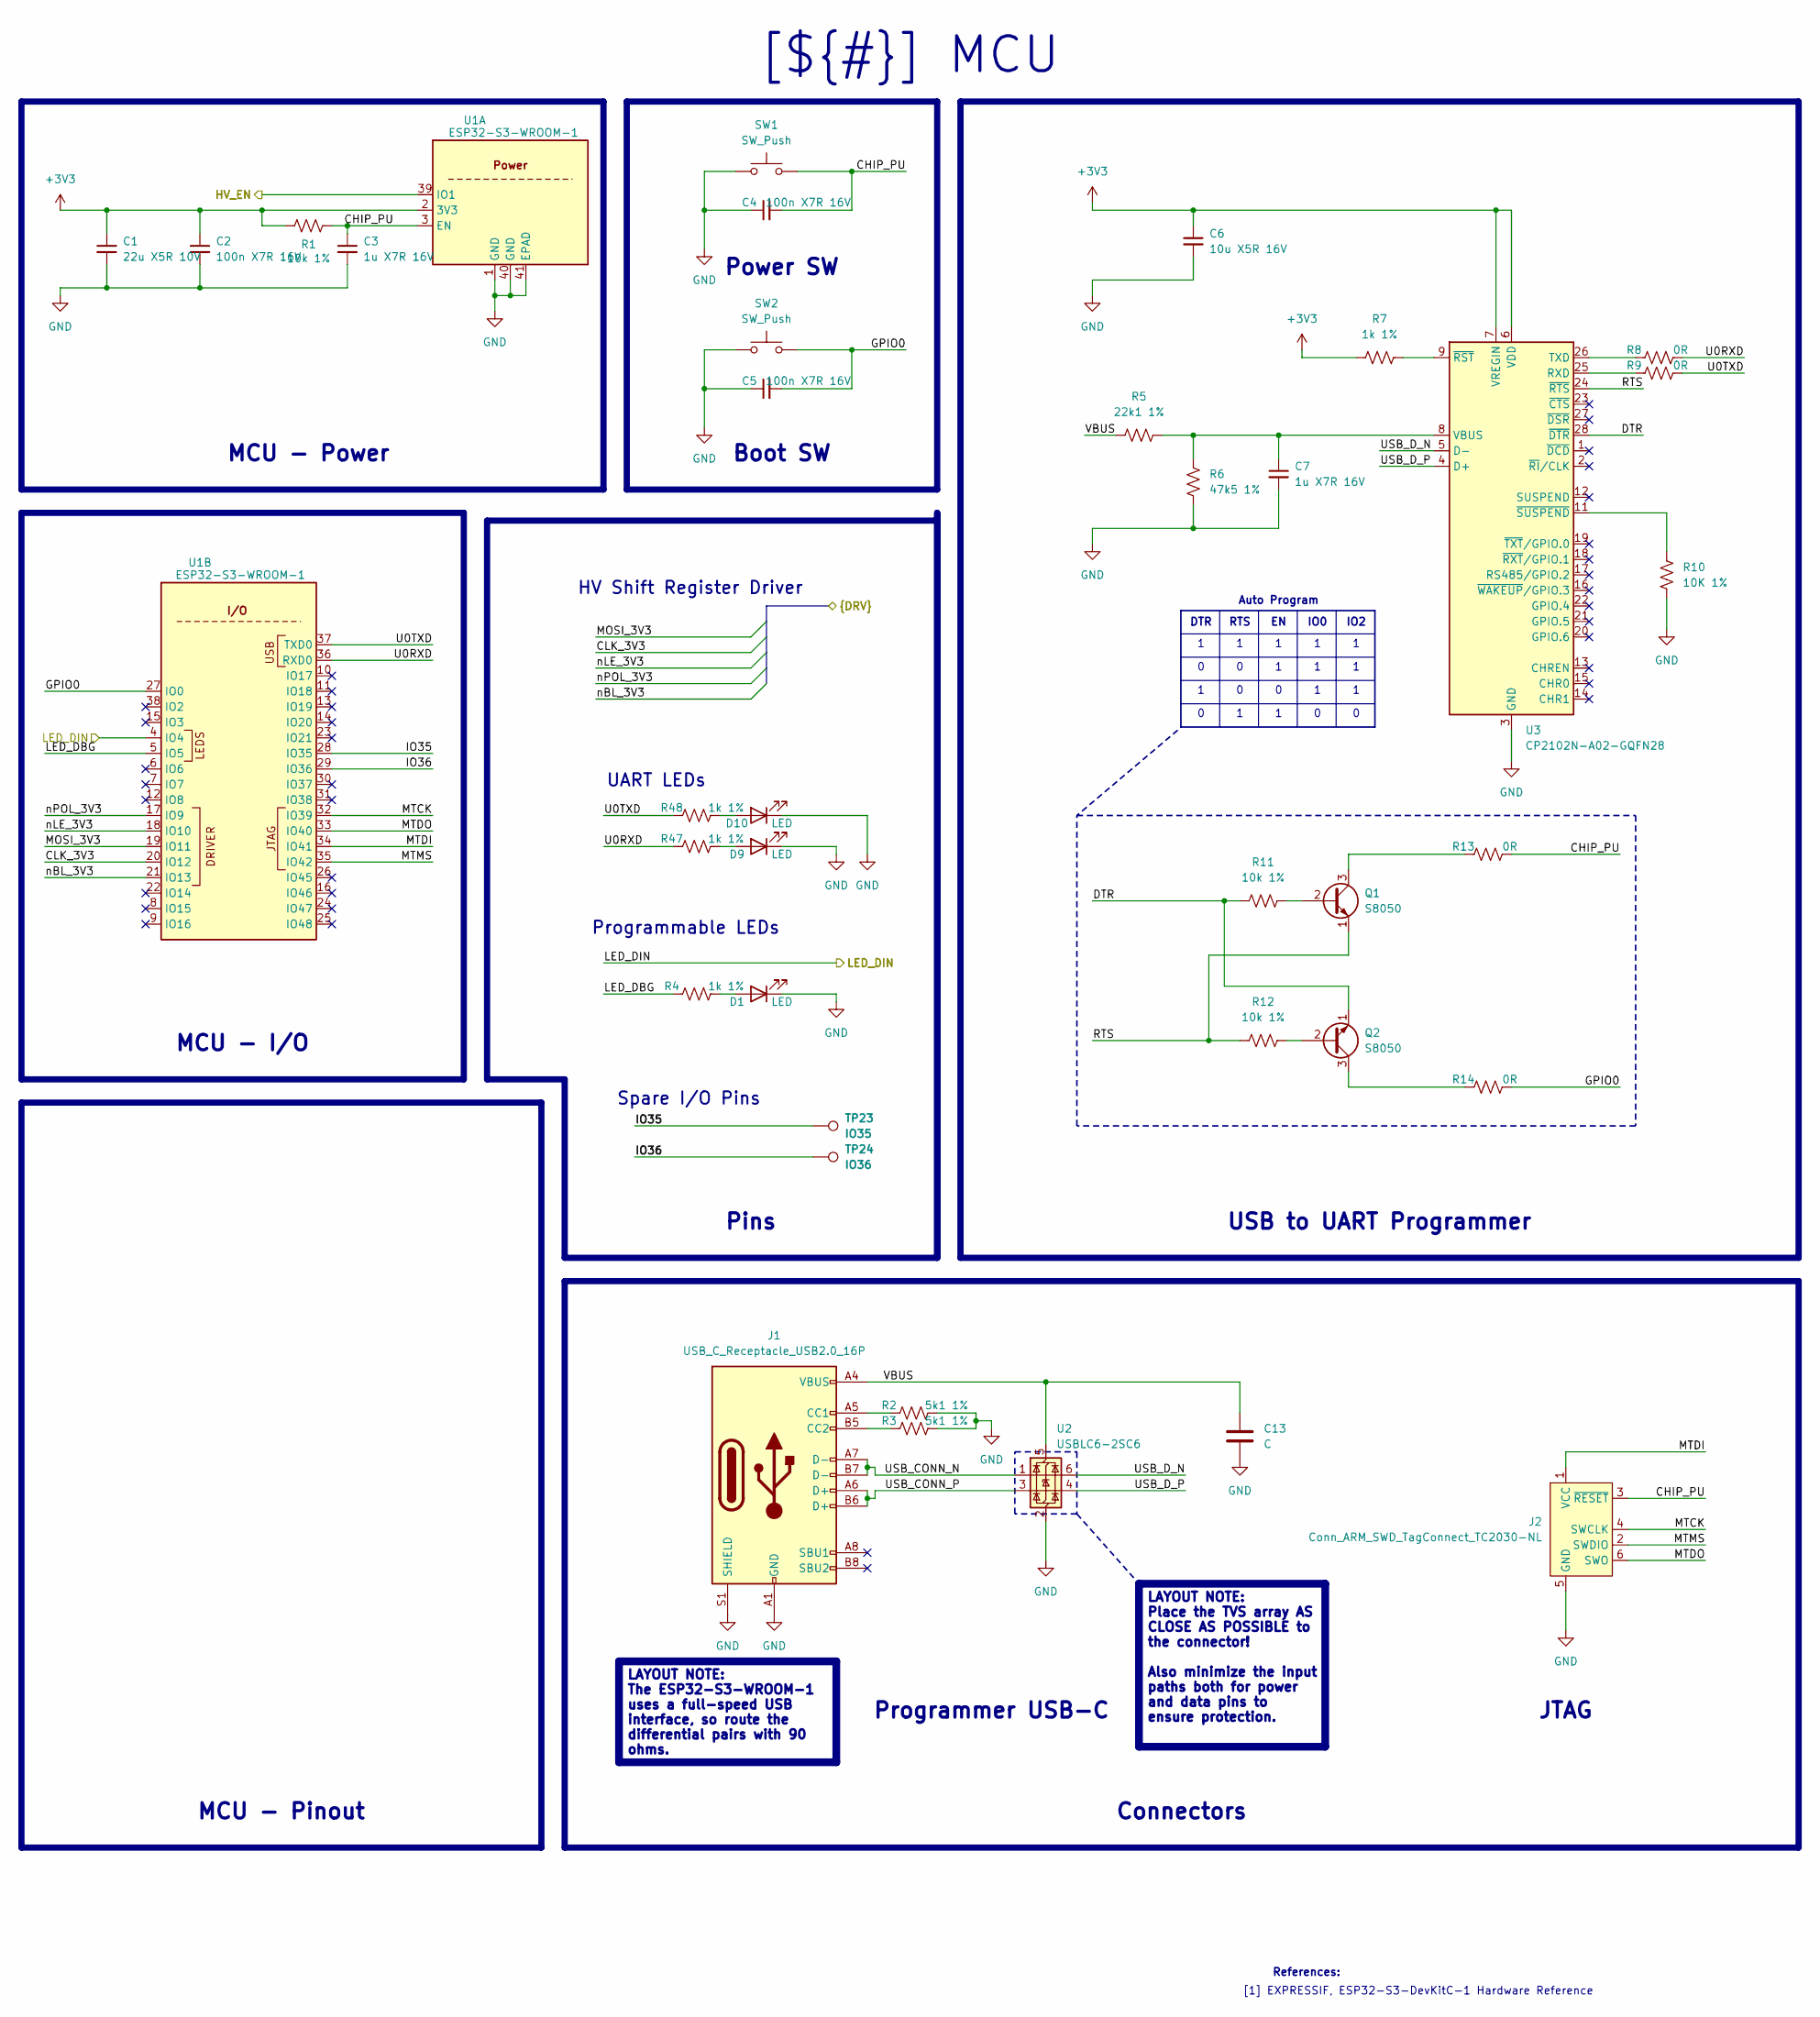
[picture p26: schematic MCU.kicad_sch]

Parts:
C1: 22u X5R 10V; C_0805_2012Metric; Part No. CL21A226MPQNNNE
C2, C4, C5: 100n X7R 16V; C_0805_2012Metric_Pad1.18x1.45mm_HandSolder; Part No. CC0805KRX7R7BB104
C3, C7: 1u X7R 16V; C_0805_2012Metric_Pad1.18x1.45mm_HandSolder; Part No. GRM21BR71C105KA01L
C6: 10u X5R 16V; C_0805_2012Metric_Pad1.18x1.45mm_HandSolder; Part No. GRM21BR61C106KE15K
C13: C
D1, D9, D10: LED; LED_0402_1005Metric_Pad0.77x0.64mm_HandSolder; Part No. VLMG1500-GS08
J1: USB_C_Receptacle_USB2.0_16P; USB_C_Receptacle_HRO_TYPE-C-31-M-12; Part No. 10155435-00011LF
J2: Conn_ARM_SWD_TagConnect_TC2030-NL; Tag-Connect_TC2030-IDC-NL_2x03_P1.27mm_Vertical
Q1, Q2: S8050; SOT-23_Handsoldering
R1, R11, R12: 10k 1%; R_0402_1005Metric_Pad0.72x0.64mm_HandSolder; Part No. AC0402FR-07107KL
R2, R3: 5k1 1%; R_0402_1005Metric_Pad0.72x0.64mm_HandSolder; Part No. RMCF0402FT4K75
R4, R7, R47, R48: 1k 1%; R_0402_1005Metric_Pad0.72x0.64mm_HandSolder; Part No. ERJ-2RKF1001X
R5: 22k1 1%; R_0402_1005Metric_Pad0.72x0.64mm_HandSolder; Part No. ERA-2ARB223X
R6: 47k5 1%; R_0402_1005Metric_Pad0.72x0.64mm_HandSolder; Part No. AC0402FR-0747K5L
R8, R9, R13, R14: 0R; R_0402_1005Metric_Pad0.72x0.64mm_HandSolder; Part No. RC0402JR-070RL
R10: 10K 1%; R_0402_1005Metric_Pad0.72x0.64mm_HandSolder; Part No. AC0402FR-07107KL
SW1, SW2: SW_Push; SW_SPST_TL3342
TP23: IO35; TestPoint_Pad_D1.0mm
TP24: IO36; TestPoint_Pad_D1.0mm
U1: ESP32-S3-WROOM-1
U2: USBLC6-2SC6; SOT-23-6
U3: CP2102N-A02-GQFN28; QFN-28-1EP_5x5mm_P0.5mm_EP3.35x3.35mm

Connections:
+3V3: C1.1, C2.1, C6.1, R1.1, R7.1, U1.2 (3V3), U3.6 (VDD), U3.7 (VREGIN); also elsewhere on the board
/Block Diagram/Logic Conversion/CLK_3V3: U1.20 (IO12); also elsewhere on the board
/Block Diagram/Logic Conversion/MOSI_3V3: U1.19 (IO11); also elsewhere on the board
/Block Diagram/Logic Conversion/nBL_3V3: U1.21 (IO13); also elsewhere on the board
/Block Diagram/Logic Conversion/nLE_3V3: U1.18 (IO10); also elsewhere on the board
/Block Diagram/Logic Conversion/nPOL_3V3: U1.17 (IO9); also elsewhere on the board
/Block Diagram/MCU/CHIP_PU: C3.1, C4.2, J2.3 (~RESET), R1.2, R13.2, SW1.2, U1.3 (EN)
/Block Diagram/MCU/DTR: Q2.1 (E), R11.1, U3.28 (~DTR)
/Block Diagram/MCU/GPIO0: C5.2, R14.2, SW2.2, U1.27 (IO0)
/Block Diagram/MCU/HV_EN: U1.39 (IO1); also elsewhere on the board
/Block Diagram/MCU/IO35: TP23.1, U1.28 (IO35)
/Block Diagram/MCU/IO36: TP24.1, U1.29 (IO36)
/Block Diagram/MCU/LED_DBG: R4.1, U1.5 (IO5)
/Block Diagram/MCU/LED_DIN: U1.4 (IO4); also elsewhere on the board
/Block Diagram/MCU/MTCK: J2.4 (SWCLK), U1.32 (IO39)
/Block Diagram/MCU/MTDI: J2.1 (VCC), U1.34 (IO41)
/Block Diagram/MCU/MTDO: J2.6 (SWO), U1.33 (IO40)
/Block Diagram/MCU/MTMS: J2.2 (SWDIO), U1.35 (IO42)
/Block Diagram/MCU/RTS: Q1.1 (E), R12.1, U3.24 (~RTS)
/Block Diagram/MCU/U0RXD: R8.2, R47.1, U1.36 (RXD0)
/Block Diagram/MCU/U0TXD: R9.2, R48.1, U1.37 (TXD0)
/Block Diagram/MCU/USB_CONN_N: J1.A7 (D-), J1.B7 (D-), U2.1 (I/O1)
/Block Diagram/MCU/USB_CONN_P: J1.A6 (D+), J1.B6 (D+), U2.3 (I/O2)
/Block Diagram/MCU/USB_D_N: U2.6 (I/O1), U3.5 (D-)
/Block Diagram/MCU/USB_D_P: U2.4 (I/O2), U3.4 (D+)
/Block Diagram/MCU/VBUS: C13.1, J1.A4 (VBUS), J1.A9 (VBUS), J1.B4 (VBUS), J1.B9 (VBUS), R5.1, U2.5 (VBUS)
GND: C1.2, C2.2, C3.2, C4.1, C5.1, C6.2, C7.2, C13.2, D1.1 (K), D9.1 (K), D10.1 (K), J1.A1 (GND), J1.A12 (GND), J1.B1 (GND), J1.B12 (GND), J1.S1 (SHIELD), J2.5 (GND), R2.2, R3.2, R6.1, R10.2, SW1.1, SW2.1, U1.1 (GND), U1.40 (GND), U1.41 (EPAD), U2.2 (GND), U3.3 (GND), U3.29 (GND); also elsewhere on the board
unnamed: D1.2 (A), R4.2
unnamed: D9.2 (A), R47.2
unnamed: D10.2 (A), R48.2
unnamed: J1.A5 (CC1), R2.1
unnamed: J1.B5 (CC2), R3.1
unnamed: Q1.2 (B), R11.2
unnamed: Q1.3 (C), R13.1
unnamed: Q2.2 (B), R12.2
unnamed: Q2.3 (C), R14.1
unnamed: R9.1, U3.25 (RXD)
unnamed: R8.1, U3.26 (TXD)
unnamed: C7.1, R5.2, R6.2, U3.8 (VBUS)
unnamed: R7.2, U3.9 (~RST)
unnamed: R10.1, U3.11 (~SUSPEND)

Notes on the sheet:
USB to UART Programmer
LAYOUT NOTE: The ESP32-S3-WROOM-1 uses a full-speed USB interface, so route the differential pairs with 90 ohms.
MCU - I/O
LAYOUT NOTE: Place the TVS array AS CLOSE AS POSSIBLE to the connector! Also minimize the input paths both for power and data pins to ensure protection.
[${#}] ${TITLE}
Boot SW
Pins
Power SW
MCU - Power
MCU - Pinout
Programmer USB-C
Connectors
JTAG
UART LEDs
RTS
References:
[1] EXPRESSIF, ESP32-S3-DevKitC-1 Hardware Reference
IO0
Auto Program
HV Shift Register Driver
DTR
Spare I/O Pins
Programmable LEDs
IO2
