electronobserver/smartnixie/hardware/control_board/control_board.kicad_pcb

## KiCad design hardware/control_board/control_board.kicad_pcb (continued)

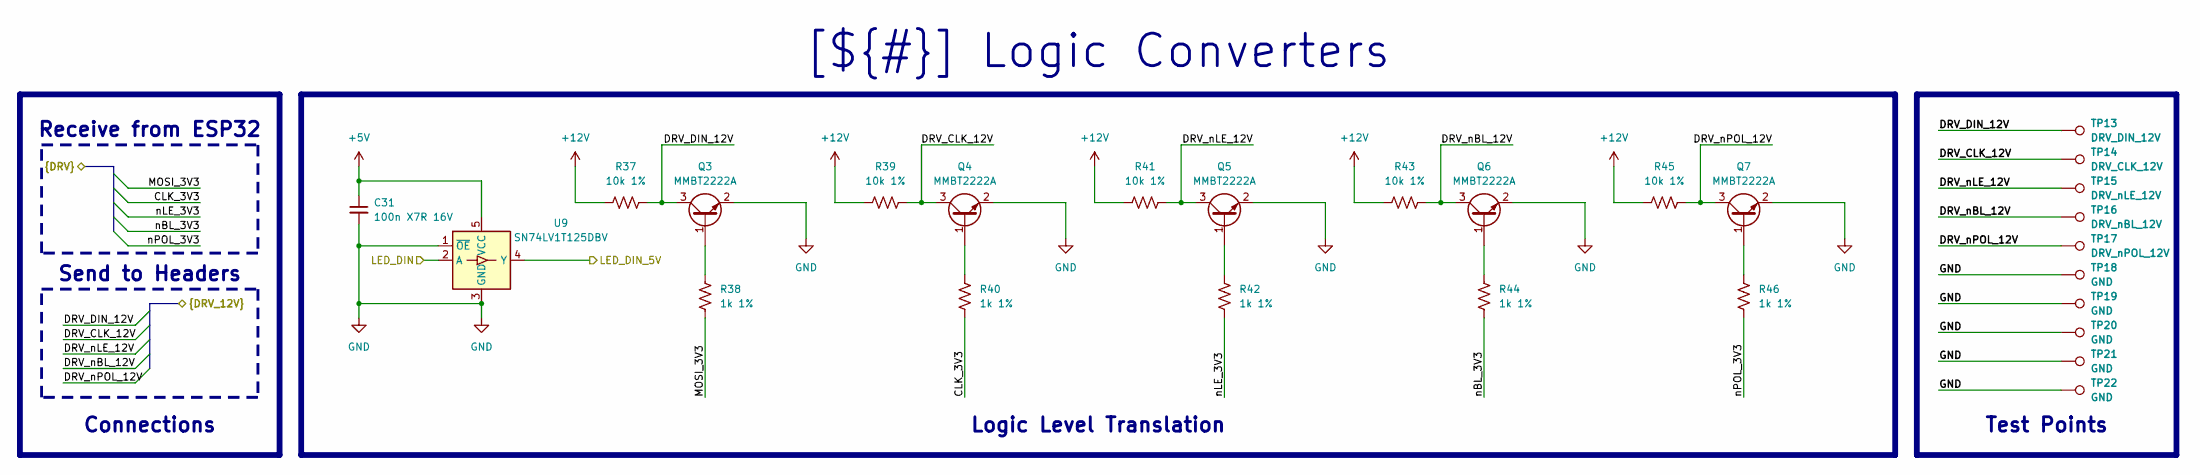
[picture p27: schematic Logic.kicad_sch, Logic Converters]

Parts:
C31: 100n X7R 16V; C_0805_2012Metric_Pad1.18x1.45mm_HandSolder; Part No. CC0805KRX7R7BB104
Q3, Q4, Q5, Q6, Q7: MMBT2222A; SOT-23
R37, R39, R41, R43, R45: 10k 1%; R_0402_1005Metric_Pad0.72x0.64mm_HandSolder; Part No. AC0402FR-07107KL
R38, R40, R42, R44, R46: 1k 1%; R_0402_1005Metric_Pad0.72x0.64mm_HandSolder; Part No. ERJ-2RKF1001X
TP13: DRV_DIN_12V; TestPoint_Pad_D1.0mm
TP14: DRV_CLK_12V; TestPoint_Pad_D1.0mm
TP15: DRV_nLE_12V; TestPoint_Pad_D1.0mm
TP16: DRV_nBL_12V; TestPoint_Pad_D1.0mm
TP17: DRV_nPOL_12V; TestPoint_Pad_D1.0mm
TP18, TP19, TP20, TP21, TP22: GND; TestPoint_Pad_D1.0mm
U9: SN74LV1T125DBV; SOT-23-5

Connections:
+5V: C31.1, U9.5 (VCC); also elsewhere on the board
+12V: R37.1, R39.1, R41.1, R43.1, R45.1; also elsewhere on the board
/Block Diagram/Logic Conversion/CLK_3V3: R40.1; also elsewhere on the board
/Block Diagram/Logic Conversion/DRV_CLK_12V: Q4.3 (C), R39.2, TP14.1; also elsewhere on the board
/Block Diagram/Logic Conversion/DRV_DIN_12V: Q3.3 (C), R37.2, TP13.1; also elsewhere on the board
/Block Diagram/Logic Conversion/DRV_nBL_12V: Q6.3 (C), R43.2, TP16.1; also elsewhere on the board
/Block Diagram/Logic Conversion/DRV_nLE_12V: Q5.3 (C), R41.2, TP15.1; also elsewhere on the board
/Block Diagram/Logic Conversion/DRV_nPOL_12V: Q7.3 (C), R45.2, TP17.1; also elsewhere on the board
/Block Diagram/Logic Conversion/LED_DIN_5V: U9.4 (Y); also elsewhere on the board
/Block Diagram/Logic Conversion/MOSI_3V3: R38.1; also elsewhere on the board
/Block Diagram/Logic Conversion/nBL_3V3: R44.1; also elsewhere on the board
/Block Diagram/Logic Conversion/nLE_3V3: R42.1; also elsewhere on the board
/Block Diagram/Logic Conversion/nPOL_3V3: R46.1; also elsewhere on the board
/Block Diagram/MCU/LED_DIN: U9.2 (A); also elsewhere on the board
GND: C31.2, Q3.2 (E), Q4.2 (E), Q5.2 (E), Q6.2 (E), Q7.2 (E), TP18.1, TP19.1, TP20.1, TP21.1, TP22.1, U9.1 (~OE), U9.3 (GND); also elsewhere on the board
unnamed: Q3.1 (B), R38.2
unnamed: Q4.1 (B), R40.2
unnamed: Q5.1 (B), R42.2
unnamed: Q6.1 (B), R44.2
unnamed: Q7.1 (B), R46.2

Notes on the sheet:
[${#}] ${TITLE}
Test Points
Connections
Logic Level Translation
Send to Headers
Receive from ESP32

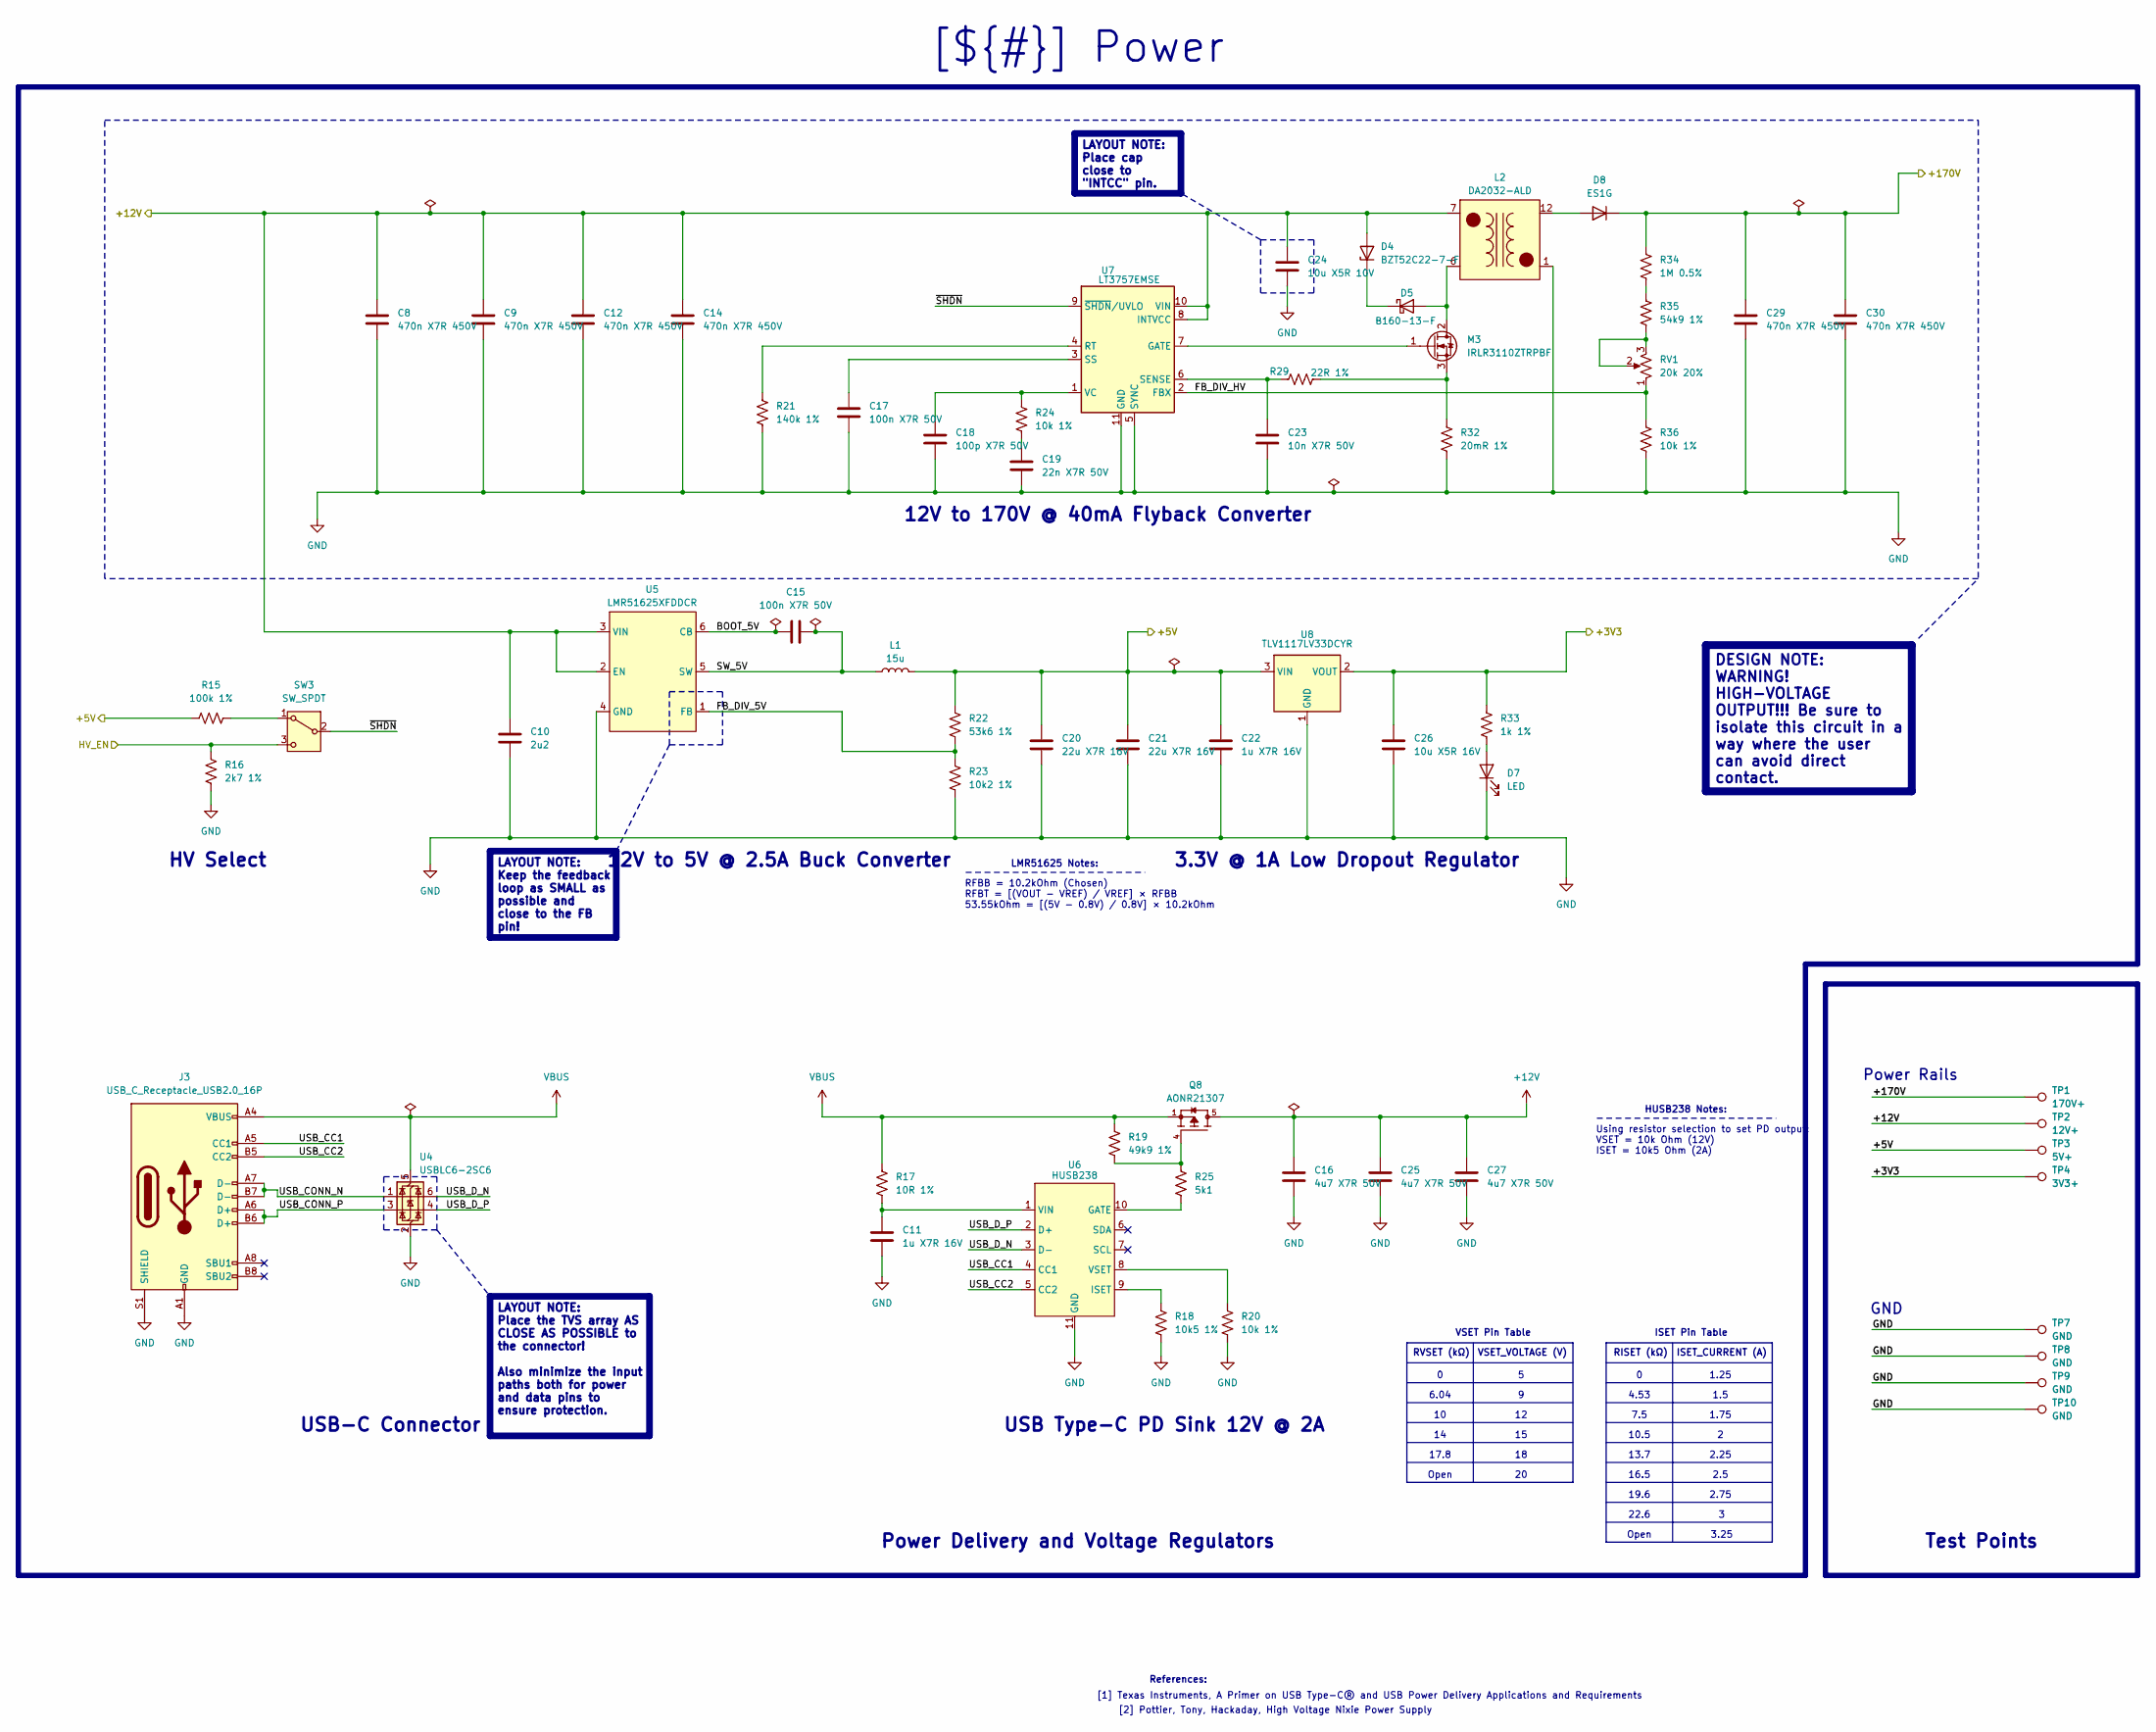
[picture p28: schematic Power.kicad_sch]

Parts:
C8, C9, C12, C14, C29, C30: 470n X7R 450V; C_1206_3216Metric_Pad1.33x1.80mm_HandSolder; Part No. LMK316BJ476ML-T
C10: 2u2; C_1206_3216Metric_Pad1.33x1.80mm_HandSolder; Part No. GCJ31CR71H225KA12L
C11, C22: 1u X7R 16V; C_0805_2012Metric_Pad1.18x1.45mm_HandSolder; Part No. GRM21BR71C105KA01L
C15, C17: 100n X7R 50V; C_0603_1608Metric_Pad1.08x0.95mm_HandSolder; Part No. CC0603KRX7R9BB104
C16, C25, C27: 4u7 X7R 50V; C_1206_3216Metric_Pad1.33x1.80mm_HandSolder; Part No. GRM31CR71H475KA12L
C18: 100p X7R 50V; C_0603_1608Metric_Pad1.08x0.95mm_HandSolder; Part No. CC0603KRX7R9BB101
C19: 22n X7R 50V; C_0603_1608Metric_Pad1.08x0.95mm_HandSolder; Part No. CC0603KRX7R9BB223
C20, C21: 22u X7R 16V; C_1206_3216Metric_Pad1.33x1.80mm_HandSolder; Part No. GRM31CR61C476ME44
C23: 10n X7R 50V; C_0603_1608Metric_Pad1.08x0.95mm_HandSolder; Part No. CC0603KRX7R9BB103
C24: 10u X5R 10V; C_0603_1608Metric_Pad1.08x0.95mm_HandSolder; Part No. CL10A106MP8NNNC
C26: 10u X5R 16V; C_0805_2012Metric_Pad1.18x1.45mm_HandSolder; Part No. GRM21BR61C106KE15K
D4: BZT52C22-7-F; D_SOD-123
D5: B160-13-F; D_SMA_Handsoldering
D7: LED; LED_0402_1005Metric_Pad0.77x0.64mm_HandSolder; Part No. VLMG1500-GS08
D8: ES1G; D_SMA_Handsoldering
J3: USB_C_Receptacle_USB2.0_16P; USB_C_Receptacle_HRO_TYPE-C-31-M-12; Part No. 10155435-00011LF
L1: 15u; L_Abracon_ASPI-0630LR-150M-T15
L2: DA2032-ALD; DA2032-AL
M3: IRLR3110ZTRPBF; TO-252-2
Q8: AONR21307; TRANS_AONR21307; PARTREV 1.1
R15: 100k 1%; R_0402_1005Metric_Pad0.72x0.64mm_HandSolder; Part No. ERJ-2RKF1003X
R16: 2k7 1%; R_0402_1005Metric_Pad0.72x0.64mm_HandSolder; Part No. ERJ-2GEJ272X
R17: 10R 1%; R_0603_1608Metric_Pad0.98x0.95mm_HandSolder; Part No. RMCF0603FT10R0
R18: 10k5 1%; R_0603_1608Metric_Pad0.98x0.95mm_HandSolder; Part No. Stackpole Electronics Inc
R19: 49k9 1%; R_0603_1608Metric_Pad0.98x0.95mm_HandSolder; Part No. RMCF0603FT49K9
R20, R24, R36: 10k 1%; R_0603_1608Metric_Pad0.98x0.95mm_HandSolder; Part No. RC0603FR-0710KL
R21: 140k 1%; R_0603_1608Metric_Pad0.98x0.95mm_HandSolder; Part No. RC0603FR-07140KL
R22: 53k6 1%; R_0201_0603Metric_Pad0.64x0.40mm_HandSolder; Part No. RC0603FR-0753K6L
R23: 10k2 1%; R_0201_0603Metric_Pad0.64x0.40mm_HandSolder; Part No. RMCF0603FT10K2
R25: 5k1; R_0603_1608Metric_Pad0.98x0.95mm_HandSolder; Part No. RC0603FR-075K1L
R29: 22R 1%; R_0603_1608Metric_Pad0.98x0.95mm_HandSolder; Part No. RC0603FR-0722RL
R32: 20mR 1%; R_1206_3216Metric_Pad1.30x1.75mm_HandSolder; Part No. PE1206FRF470R02L
R33: 1k 1%; R_0402_1005Metric_Pad0.72x0.64mm_HandSolder; Part No. ERJ-2RKF1001X
R34: 1M 0.5%; R_1206_3216Metric_Pad1.30x1.75mm_HandSolder; Part No. RT1206DRE071ML
R35: 54k9 1%; R_0201_0603Metric_Pad0.64x0.40mm_HandSolder; Part No. RC0603FR-0754K9L
RV1: 20k 20%; Potentiometer-3313J; Part No. 3313J-1-203E
SW3: SW_SPDT; CLSB12B01T; Part No. CL-SB-12B-01T
TP1: 170V+; TestPoint_Pad_D1.0mm
TP2: 12V+; TestPoint_Pad_D1.0mm
TP3: 5V+; TestPoint_Pad_D1.0mm
TP4: 3V3+; TestPoint_Pad_D1.0mm
TP7, TP8, TP9, TP10: GND; TestPoint_Pad_D1.0mm
U4: USBLC6-2SC6; SOT-23-6
U5: LMR51625XFDDCR; TSOT-23-6
U6: HUSB238; DFN-10_3x3mm
U7: LT3757EMSE; MSOP-10-1EP_3x3mm_P0.5mm_EP1.68x1.88mm_ThermalVias
U8: TLV1117LV33DCYR; SOT-223

Connections:
+3V3: C26.1, R33.2, TP4.1, U8.2 (VOUT), U8.4; also elsewhere on the board
+5V: C20.1, C21.1, C22.1, L1.2, R15.1, R22.1, TP3.1, U8.3 (VIN); also elsewhere on the board
+12V: C8.1, C9.1, C10.1, C12.1, C14.1, C16.1, C24.1, C25.1, C27.1, D4.2 (A), L2.7, L2.8, L2.9, L2.10, Q8.5, Q8.6, Q8.7, Q8.8, TP2.1, U5.2 (EN), U5.3 (VIN), U7.8 (INTVCC), U7.10 (VIN); also elsewhere on the board
+170V: C29.1, C30.1, D8.1 (K), R34.1, TP1.1; also elsewhere on the board
/Block Diagram/MCU/HV_EN: R16.1, SW3.3 (C); also elsewhere on the board
/Block Diagram/Power/BOOT_5V: C15.1, U5.6 (CB)
/Block Diagram/Power/FB_DIV_5V: R22.2, R23.1, U5.1 (FB)
/Block Diagram/Power/FB_DIV_HV: R36.1, RV1.1, U7.2 (FBX)
/Block Diagram/Power/SW_5V: C15.2, L1.1, U5.5 (SW)
/Block Diagram/Power/USB_CC1: J3.A5 (CC1), U6.4 (CC1)
/Block Diagram/Power/USB_CC2: J3.B5 (CC2), U6.5 (CC2)
/Block Diagram/Power/USB_CONN_N: J3.A7 (D-), J3.B7 (D-), U4.1 (I/O1)
/Block Diagram/Power/USB_CONN_P: J3.A6 (D+), J3.B6 (D+), U4.3 (I/O2)
/Block Diagram/Power/USB_D_N: U4.6 (I/O1), U6.3 (D-)
/Block Diagram/Power/USB_D_P: U4.4 (I/O2), U6.2 (D+)
/Block Diagram/Power/~SHDN: SW3.2 (B), U7.9 (~SHDN/UVLO)
GND: C8.2, C9.2, C10.2, C11.2, C12.2, C14.2, C16.2, C17.2, C18.2, C19.2, C20.2, C21.2, C22.2, C23.2, C24.2, C25.2, C26.2, C27.2, C29.2, C30.2, D7.1 (K), J3.A1 (GND), J3.A12 (GND), J3.B1 (GND), J3.B12 (GND), J3.S1 (SHIELD), L2.1, R16.2, R18.2, R20.2, R21.2, R23.2, R32.2, R36.2, TP7.1, TP8.1, TP9.1, TP10.1, U4.2 (GND), U5.4 (GND), U6.11 (GND), U7.5 (SYNC), U7.11 (GND), U8.1 (GND); also elsewhere on the board
unnamed: C19.1, R24.2
unnamed: D4.1 (K), D5.1 (K)
unnamed: D5.2 (A), L2.3, L2.4, L2.5, L2.6, M3.2
unnamed: D7.2 (A), R33.1
unnamed: D8.2 (A), L2.12
unnamed: M3.3, R29.2, R32.1
unnamed: Q8.4, R19.2, R25.1
unnamed: R34.2, R35.1
unnamed: R35.2, RV1.2, RV1.3
unnamed: R15.2, SW3.1 (A)
unnamed: R25.2, U6.10 (GATE)
unnamed: R18.1, U6.9 (ISET)
unnamed: C11.1, R17.2, U6.1 (VIN)
unnamed: R20.1, U6.8 (VSET)
unnamed: M3.1, U7.7 (GATE)
unnamed: R21.1, U7.4 (RT)
unnamed: C23.1, R29.1, U7.6 (SENSE)
unnamed: C17.1, U7.3 (SS)
unnamed: C18.1, R24.1, U7.1 (VC)
VBUS: J3.A4 (VBUS), J3.A9 (VBUS), J3.B4 (VBUS), J3.B9 (VBUS), Q8.1, Q8.2, Q8.3, R17.1, R19.1, U4.5 (VBUS)

Notes on the sheet:
LAYOUT NOTE: Keep the feedback loop as SMALL as possible and close to the FB pin!
LAYOUT NOTE: Place the TVS array AS CLOSE AS POSSIBLE to the connector! Also minimize the input paths both for power and data pins to ensure protection.
DESIGN NOTE: WARNING! HIGH-VOLTAGE OUTPUT!!! Be sure to isolate this circuit in a way where the user can avoid direct contact.
USB Type-C PD Sink 12V @ 2A
USB-C Connector
HV Select
[${#}] ${TITLE}
Power Delivery and Voltage Regulators
12V to 170V @ 40mA Flyback Converter
12V to 5V @ 2.5A Buck Converter
Test Points
3.3V @ 1A Low Dropout Regulator
LAYOUT NOTE: Place cap close to "INTCC" pin.
GND
RFBB = 10.2kOhm (Chosen) RFBT = [(VOUT − VREF) / VREF] × RFBB 53.55kOhm = [(5V − 0.8V) / 0.8V] × 10.2kOhm
2.25
[2] Pottier, Tony, Hackaday, High Voltage Nixie Power Supply
13.7
[1] Texas Instruments, A Primer on USB Type-C® and USB Power Delivery Applications and Requirements
LMR51625 Notes:
7.5
4.53
10.5
19.6
Open
2.5
3.25
ISET Pin Table
Using resistor selection to set PD output: VSET = 10k Ohm (12V) ISET = 10k5 Ohm (2A)
16.5
References:
2.75
ISET_CURRENT (A)
VSET_VOLTAGE (V)
6.04
RISET (kΩ)
22.6
VSET Pin Table
1.5
1.25
17.8
HUSB238 Notes:
RVSET (kΩ)
Power Rails
1.75

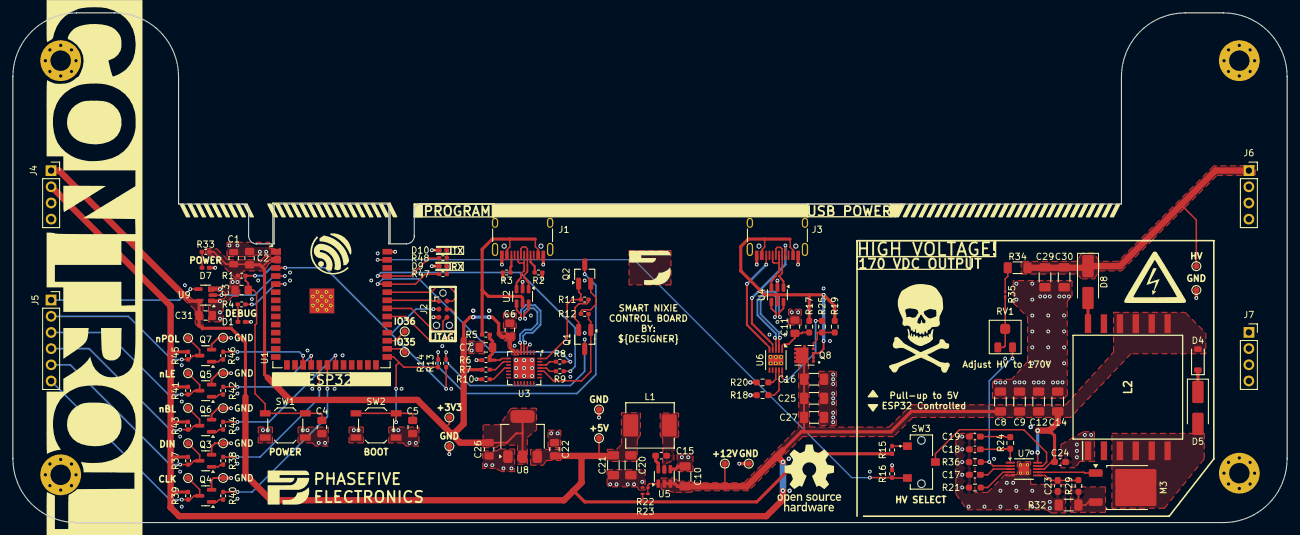
[picture p29: board control_board.kicad_pcb from above]

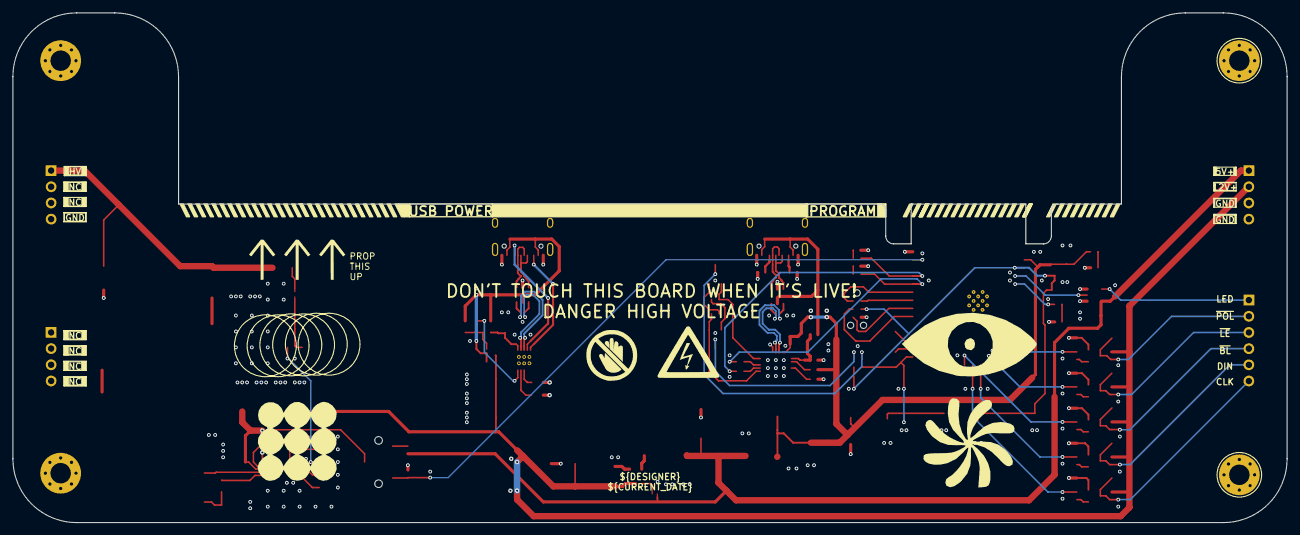
[picture p30: board control_board.kicad_pcb from below]

Board: 4 copper layers, 200.0 x 80.0 mm, 149 parts (8 on the bottom side), 86 nets.

Other parts of the board:
G1, G8: LOGO; P5Logo
G2: LOGO; AbstractDecal1
G3: LOGO; OSHW
G3#2: LOGO; SidePanelArt
G4: LOGO; Expressif
G5: LOGO; NoTouch
G6, G11: LOGO; HV
G7: LOGO; AbstractDecal3
G9: LOGO; AbstractDecal2
G10: LOGO; Skull
G12, G13, G14: LOGO; Arrow
