electronobserver/smartnixie/(commit log)

2025-11-08 Minor improvements + redirecting footprints to map to the general 3D models folder
2025-11-08 Removing images generated for silkscreen art and only keeping ones used directly in schematic
2025-11-08 Tweaking existing gerber files and schematics to comply with new project structure
    [clock_face.kicad_pcb, clock_face.kicad_sch, control_board.kicad_pcb, control_board.kicad_sch, main.kicad_sch]
